jungguck/mobile_robot_proto_type/docs/wiki/entities/Relay_Robot_Hardware.md

# 🤖 Relay Robot Hardware

이 페이지는 프로젝트에 사용된 주요 하드웨어 구성 요소와 사양을 기록합니다.

## DDSM400 모터
- **타입**: Direct Drive Smart Motor (차륜형 로봇용).
- **특징**: 고토크, 정밀 인코더 내장.
- **통신**: Waveshare DDSM 드라이버 HAT 을 통한 JSON over Serial (`/dev/motor`, 115200).

### 통신 규약 (2026-08-22 실측 확정)
| 항목 | 값 |
|---|-----|
| 보드 타입 설정 | `{"T":11002,"type":210}` — **전원 사이클당 1회 필수** |
| 속도 제어 | `{"T":10010,"id":N,"cmd":X,"act":10}` |
| 모드 설정 | `{"T":10012,"id":N,"mode":2}` (2 = speed loop) |
| `cmd` / `spd` 단위 | **0.1 RPM** (cmd 100 = 10 RPM) |
| 피드백 | `{"T":20010,"id":..,"typ":400,"spd":..,"crt":..,"tep":..,"err":0}` |
| 피드백 시점 | **명령을 받았을 때만** 회신 (주기적 전송 없음) |
| heartbeat | 기본 `-1` = **비활성**. 정지 명령 없으면 무한 회전 |

> ⚠️ **`type` 은 반드시 `210`.** 모터는 스스로를 `typ:400` 이라고 보고하지만,
> 펌웨어(`ddsm_example.ino: set_ddsm_type`)는 `115` / `210` 만 인정하고
> 그 외 값은 **조용히 무시**한다. 이걸 빼먹으면 보드가 구동 명령에 응답조차 하지 않는다.
> 자세한 내용: [[Debugging_Experience#7]]

### 모터 배치 / 부호 규약 (2026-08-22 실측 확정)
| 항목 | 값 |
|---|-----|
| id = 1 | **오른쪽** 바퀴 |
| id = 2 | **왼쪽** 바퀴 |
| 전진 부호 | R = **음수**, L = **양수** |

> 좌우 허브모터가 거울 대칭으로 장착돼 있다.
> 이 부호는 `MotorDriver` 의 `DIR_R = -1` / `DIR_L = +1` 이 전부 흡수하므로,
> **드라이버 바깥에서는 부호를 건드리지 마라.** ("+ = 로봇 전진") [[Debugging_Experience#9]]

### 기구학 설정값
| 항목 | 값 | 상태 |
|---|-----|---|
| 바퀴 반지름 | 0.0325 m (지름 65mm) | ✅ **확정** (2026-09-03) |
| 양 바퀴 중심거리 | 0.22 m | ✅ **확정** (2026-09-03) |
| spd → m/s 변환 계수 | `/600.0` | ✅ 확정 |
| 명령 변환 계수 | `×600` (`calculate_rpms()`) | ✅ 확정 |

> ✅ **기구학 상수는 전부 확정됐다. 재측정을 제안하지 말 것.**
> 2026-08-22 문서에 있던 "지름 6.5cm vs 역산 7.4cm 14% 불일치" 는 **무효다.**
> 그 근거였던 60cm 는 줄자 실측이 아니라 눈대중이었고, 이후 확인 결과 6.5cm 가 맞다.
> 즉 **모순은 처음부터 없었다.** 자세한 경위는 `docs/DEBUG_LOG_2026-09-03.md` 2절.

## RPLidar (2026-09-06 실측 정정)

> ⚠️ 이전에 "A1/A2 계열" 로 적혀 있었으나 **틀렸다.** 실물은 **1,000,000 보드**를 쓰는
> **S2/S3 계열**이다. A1 설정(115200)으로 띄우면 `SL_RESULT_OPERATION_TIMEOUT` 으로 죽는다.

| 항목 | 값 | 근거 |
|---|-----|---|
| 포트 | `/dev/rplidar` (CP2102N, `10c4:ea60`) | udev 규칙 |
| **보드레이트** | **1000000** | 프로토콜 직접 탐색 (115200/256000/460800 전부 무응답) |
| scan_mode | `DenseBoost` | `sllidar_s2_launch.py` |
| model 코드 | `0x81` (펌웨어 1.02 / 하드웨어 18) | `GET_INFO` 응답 |
| 스캔 주기 | **10 Hz** | 실측 `ros2 topic hz /scan` |
| 스캔당 유효 포인트 | **2780개** | 실측 |
| angle_increment | 0.00194 rad (약 0.111°) | 실측 |
| range_min / max | 0.05 m / **40 m** | 실측 (40m 면 S3 가능성) |
| **Topic** | `/scan` | |
| **Frame ID** | `lidar_v1_1` | 메인 launch 가 지정. 단독 launch 기본값은 `laser` 라 다름 |

**단독 실행 시:**
```bash
ros2 launch sllidar_ros2 sllidar_s2_launch.py serial_port:=/dev/rplidar
```
> ★ `serial_port` 를 반드시 넘길 것. launch 기본값이 `/dev/ttyUSB0` 인데 **그건 IMU 다.**
> 메인 launch(`real_robot_260519.launch.py`)는 이미 올바르게 지정돼 있다.

## EB-IMU
- **모델**: E2BOX EBIMU9DOFV5. 포트 `/dev/ttyimu` (CP2102, 115200).
- **역할**: EKF 의 방향(yaw) 소스. 바퀴 오도메트리의 회전 오차를 보정.
- **[2026-09-22] 선택 사항이 됐다.** 2D SLAM 에서 yaw 를 잡는 주체는 라이다
  scan matching 이므로 IMU 없이 돈다(기본값). `use_imu:=true` 로만 위 역할을 한다.
  대신 매핑 중 각속도 ≤ 0.5 rad/s 를 지켜야 한다 — IMU 가 없으면 스캔 내 모션
  왜곡(de-skew)을 보정할 수단이 없다. 근거: `docs/DEBUG_LOG_2026-09-22.md`.
- **Topic**: `/ebimu_data` (`sensor_msgs/Imu`)

### 출력 포맷 (2026-08-22 실측)
현재 이 센서는 **자세 3개 필드만** 내보낸다.
```
*ROLL,PITCH,YAW        예: *-5.82,-2.39,135.80
```
9개 필드(`*ROLL,PITCH,YAW,ACCX,ACCY,ACCZ,GYROX,GYROY,GYROZ`) 설정도 가능하지만
지금은 그렇게 설정돼 있지 않다.

> ⚠️ **가속도·자이로 값이 없다.** 따라서 EKF 에서 `v_yaw` 와 선가속도를 쓸 수 없고,
> 절대 yaw 만 사용한다. `ebimu_publisher.py` 는 두 포맷을 모두 처리하며,
> 3필드일 때는 해당 항목의 `covariance[0]` 을 `-1`(미제공)로 표시한다.
> [[Debugging_Experience#11]]

## 전원 (2026-09-06 조사 + 실측)

**현재 구성: 모터와 젯슨은 전원을 따로 공급한다.** (공유 레일이 아니므로 모터 기동 시
전압 강하로 젯슨이 리셋될 위험은 없다. 이 분리를 깨지 말 것 — 아래 '왜 중요한가' 참고)

| 장치 | 입력 전압 | 소비 | 근거 |
|---|---|---|---|
| Jetson Orin Nano 개발자킷 | **DC잭 9–20V** (권장 19V) | 유휴 4.74W, 센서 2개 구동 시 4.04W, 모드 **15W** | 캐리어보드 P3768 회로도 `DC JACK POWER PATH ... VOLTAGE:9V-20V` + INA3221 실측 |
| DDSM400 ×2 | 정격 **25.2V** | 정격 0.24±0.07A, 무부하 0.25A, 구속 1.0±0.2A | Waveshare 사양 |
| RPLidar (S2 계열) | 5V | 스캐너 300~350mA, 모터 100mA, 기동 서지 500~600mA | Slamtec 데이터시트 |
| EBIMU | 5V (USB) | 무시 가능 | |

> **2026-09-13 현재 구성 변경 중 — 12V.** 젯슨 DC잭 9–20V 범위 안이라 동작은 정상이나
> 모터는 정격 25.2V 대비 **최고속도가 절반 이하**가 된다(아래 표). 전원 분리는 유지한다.
> 같은 날 **USB 장치 3개가 모두 물리적으로 분리된 상태**가 확인됐다 — `lsusb` 에 허브 2개와
> 블루투스뿐이고 `/dev/motor`·`/dev/rplidar`·`/dev/ttyimu` 가 전부 없다. udev 규칙은 젯슨에
> 남아 있으므로 다시 꽂으면 별칭도 복귀한다. `docs/DEBUG_LOG_2026-09-13.md` 6·7절

### 12V 로 구동할 때 알아둘 것

세 장치 모두 12V 에서 **동작은 한다.** 다만 모터는 정격이 25.2V 라 대가가 있다.

| | 25.2V (정격) | **12V** |
|---|---|---|
| 무부하 회전수 | 400 RPM | **약 190 RPM** |
| 바퀴 선속도 (r=0.0325) | 1.36 m/s | **약 0.65 m/s** |

속도상수가 **15.9 RPM/V** 이므로 최고 회전수가 전압에 정비례한다.
**토크는 안 줄어든다** — 토크상수(0.3 Nm/A)는 전압과 무관하고, 12V 는 속도 천장만 만든다.

> ⚠️ **"로봇이 이상하게 느리다" 는 코드 문제가 아닐 수 있다.**
> 12V 로 물려 있으면 최고속도가 원래 절반 이하다. `rpm_scale` 이나 기구학 상수를
> 다시 의심하지 말 것 — 그 값들은 2026-09-03 에 확정됐다.

### 왜 전원 분리가 중요한가

모터 기동·구속 순간 전류가 튀면 레일 전압이 주저앉는다. 젯슨과 레일을 공유하는데
순간적으로 **9V 아래로 떨어지면 젯슨이 브라운아웃으로 리셋된다.**
이 젯슨은 **SD 카드 부팅**이라 쓰기 중 리셋은 곧 카드 손상이다. 실제로 한 번 겪었다.

공유 레일을 쓸 수밖에 없다면: 젯슨 입력단 벌크 커패시터 + 12V 기준 **5A(60W) 이상** 공급.
## 제어 PC (로봇 탑재) — 2026-09-06 갱신

> 이전에 "Ubuntu 20.04 / ROS 2 Foxy" 로 적혀 있었으나 **낡은 정보다.**
> 지금은 젯슨이 직접 노드를 돌린다.

| 항목 | 값 |
|---|-----|
| 보드 | **Jetson Orin Nano 개발자 키트** (호스트명 `frlab`) |
| OS | Ubuntu 22.04 (JetPack 6.2.1 / L4T R36.4.7, aarch64) |
| ROS | **ROS 2 Humble** (`/opt/ros/humble`) |
| 부팅 장치 | **SD 카드** `/dev/mmcblk0p1` (ext4, 57G) — 전원 차단에 취약 |
| 메모리 | 7.4 GB |
| 전원 모드 | 15W |
| 접속 | `ssh robot` (키 인증). `docs/REMOTE_ACCESS.md` |
| 워크스페이스 | `~/mobile_robot_proto_type` (`colcon build --symlink-install`) |

> ⚠️ **numpy 는 2.2.6 이고 의도된 것이다. 1.x 로 내리지 말 것.**
> tube MPC 스택(`cvxpy`/`osqp`/`clarabel`)이 요구한다. ROS 라이브러리가 numpy 2 에서
> 깨지면 numpy 를 내리지 말고 그 라이브러리를 올린다. `docs/DEBUG_LOG_2026-09-06.md` 3절.

**비고**: 코드는 Foxy / Humble / Jazzy 모두에서 빌드된다. 자세한 호환표는 README 참고.
