jungguck/mobile_robot_proto_type/README_ROBOT.md

# Relay Robot: ROS2 MPC + SLAM 자율주행

DDSM400 모터 + RPLidar(S2 계열) 기반 차동 구동 모바일 로봇.  
Cartographer SLAM으로 지도 생성 → A* 경로 계획 → Tube-MPC 제어기로 목표 좌표 자율 주행.

> **IMU 는 선택 사항이다 (2026-09-22 기준 기본값: 끔).** 2D SLAM 은 라이다 scan matching 이
> yaw 를 잡아주므로 IMU/EKF 없이 돈다. 바퀴 오도메트리의 드리프트는 cartographer 가
> `map → odom` TF 로 흡수한다. IMU + EKF 구성으로 되돌리려면 `use_imu:=true`.
> 자세한 근거는 `docs/DEBUG_LOG_2026-09-22.md`.

---

## 파일 구조 및 관계도

> **2026-09-22 정리.** 안 쓰는 파일은 전부 `old_file/` 로 옮겼다 (지운 게 아니다).
> 무엇을 왜 옮겼는지는 `old_file/README.md`. 아래가 **지금 실제로 도는 전부**다.

### 읽는 순서 (공부할 때)

```
1. real_robot_driver_260519.py   모터 + 바퀴 오도메트리 + TF     <- 여기부터
2. motor_drive_1.py              시리얼 프로토콜 (부호·단위가 여기서 흡수됨)
3. my_cartographer.lua           SLAM 파라미터
4. path_planner.py               A* — 지도 팽창 + 격자 탐색
5. bridge_node.py                Tube-MPC — 참조 궤적 + QP
6. TubeMPCPlanner.py             MPC 수학 (제약 집합 / tube)
```

### 활성 파일 전체

```
src/
├── relayrobot_description/              ★ 로봇 본체 패키지
│   ├── relayrobot_description/
│   │   ├── real_robot_driver_260519.py  ★ 모터 + 휠 odom + TF (use_imu 로 동작 바뀜)
│   │   ├── motor_drive_1.py             ★ DDSM 시리얼. 부호(DIR_L/DIR_R)·단위를 흡수
│   │   ├── odom_calibrate.py              기구학 보정 도구 (직진/회전)
│   │   └── odom_listener.py               /odom 을 터미널에 찍는 최소 예제
│   │                                        (2026-09-22 에 relayrobot_driver 의
│   │                                         odom_sub 와 합쳤다)
│   ├── launch/
│   │   ├── real_robot_260519.launch.py  ★ 메인. 모터+LiDAR (+IMU/EKF 는 use_imu:=true)
│   │   └── cartographer.launch.py       ★ SLAM
│   ├── config/
│   │   ├── my_cartographer.lua          ★ SLAM 파라미터 (use_imu_data=false)
│   │   ├── ekf.yaml                       use_imu:=true 일 때만 쓰임
│   │   └── nav.rviz                       PC 용 RViz 프리셋
│   └── urdf/relayrobot.xacro            ★ 링크·조인트. lidar_v1_1 위치가 SLAM 에 직결
│
├── mpc_tubempc_bridge/                  ★ 자율주행 (SLAM -> A* -> MPC)
│   └── src/mpc_tubempc_bridge/
│       ├── path_planner.py              ★ A* + 장애물 팽창 (/map -> /global_path)
│       └── bridge_node.py               ★ Tube-MPC. TF(map->base_link)로 위치를 받는다
│
├── ddsm_example/
│   ├── mpc_tubempc/TubeMPCPlanner.py    ★ MPC 수학. bridge_node 가 sys.path 로 가져온다
│   │                                       (경로가 코드에 박혀 있어 옮기면 안 됨)
│   └── ddsm_example/*.ino, json_cmd.h     보드 펌웨어 소스.
│                                           프로토콜이 의심되면 문서 말고 이걸 본다
├── ebimu_pkg/ebimu_pkg/ebimu_publisher.py  IMU 드라이버. use_imu:=true 일 때만
├── gui_py/gui_py/hardware_test.py       ★ 원격 조종 GUI (/cmd_vel 발행). ssh -X 로 띄움
└── sllidar_ros2/                          서드파티. 우리는 sllidar_s2_launch.py 만 씀

scripts/robot-up.sh                      ★ tmux 상시 기동 (sensors|full|slam|nav)
tools/odom_check.py                        PC 에서 원격 오도메트리 진단
tools/mpc_sim.py                           로봇 없이 MPC 리허설
docs/DEBUG_LOG_<날짜>.md                  ★ 세션 기록. 최신 것이 정본
old_file/                                  보관소. COLCON_IGNORE 라 빌드 영향 없음
```

> ★ = 실주행 체인에 직접 관여. 나머지는 도구/보조.

### 토픽 / TF 흐름

```
[하드웨어]                [드라이버 노드]              [토픽]
/dev/ttyACM0  ──►  real_robot_driver_260519  ──►  /odom_raw  (nav_msgs/Odometry)
                                             ──►  /joint_states
                   sub: /cmd_vel ◄───────────────────────────
/dev/rplidar  ──►  sllidar_node              ──►  /scan      (sensor_msgs/LaserScan)

  ※ 위 /odom_raw 는 use_imu:=true 일 때의 토픽 이름이다.
    기본(IMU 없음)에서는 드라이버가 /odom 과 TF 를 직접 낸다 ↓

[오도메트리]  — 기본: IMU 없음
real_robot_driver_260519  ──►  /odom (nav_msgs/Odometry)
                          ──►  TF: odom → base_link

[오도메트리]  — use_imu:=true 일 때만
/dev/ttyimu ──► ebimu_publisher ──► /ebimu_data ──┐
                                                  ├──► ekf_filter_node ──► /odom
                         real_robot_driver ──► /odom_raw ──┘            ──► TF: odom → base_link

[SLAM]
/scan + TF(odom→base_link)  ──►  cartographer_node  ──►  /map (OccupancyGrid)
                                                     ──►  TF: map → odom
                                                          (= 누적 드리프트 보정분)

[경로 계획]
/map + TF(map→base_link) + /mpc_goal  ──►  path_planner (A*)  ──►  /global_path

[MPC 제어]
TF(map→base_link) + /global_path  ──►  bridge_node (TubeMPC)  ──►  /cmd_vel
                           (내부 의존: ddsm_example/mpc_tubempc/TubeMPCPlanner.py)

  ※ 제어·계획은 /odom 이 아니라 map→base_link TF 를 쓴다. /odom 은 odom 프레임이고
    목표·경로는 map 프레임이라 서로 원점이 다르다. 차이가 곧 SLAM 보정분이다.
    (src/mpc_tubempc_bridge/.../pose_source.py)

[TF 트리 전체]
map ──[cartographer]──► odom ──[드라이버 또는 ekf_node]──► base_link
                                                            └─[robot_state_publisher]──► lidar_v1_1
                                                                                      ──► left_wheel_v1_1
                                                                                      ──► right_wheel_v1_1
  ★ odom→base_link 발행자는 **반드시 하나**여야 한다. use_imu 가 그걸 결정한다.
```

### 주요 ROS2 토픽 정리

| 토픽 | 타입 | 발행 노드 |
|---|---|---|
| `/odom` | `nav_msgs/Odometry` | real_robot_driver_260519 (기본) |
| `/odom_raw` | `nav_msgs/Odometry` | real_robot_driver_260519 (`use_imu:=true` 일 때) |
| `/odom` | `nav_msgs/Odometry` | ekf_filter_node (`use_imu:=true` 일 때, remapped) |
| `/ebimu_data` | `sensor_msgs/Imu` | ebimu_publisher (`use_imu:=true` 일 때) |
| `/scan` | `sensor_msgs/LaserScan` | sllidar_node |
| `/map` | `nav_msgs/OccupancyGrid` | cartographer_node |
| `/mpc_goal` | `geometry_msgs/PoseStamped` | 외부 입력 (ros2 topic pub / GUI) |
| `/global_path` | `nav_msgs/Path` | path_planner |
| `/cmd_vel` | `geometry_msgs/Twist` | bridge_node |

---

## 시스템 요구사항

> **2026-09-22 정정. 이 문서는 예전에 Jazzy/Ubuntu 24.04 로만 적혀 있었는데 틀렸다.**
> 로봇(젯슨)은 **JetPack 6.2.1 = L4T 36.x = Ubuntu 22.04 = ROS 2 Humble** 이다.
> `ros-jazzy-*` 를 22.04 에 설치하려 하면 패키지를 못 찾는다.
> 근거: `docs/DEBUG_LOG_2026-09-03.md` 4절, `docs/JETSON_SETUP.md`.

| | 로봇 (젯슨 Orin Nano) | 개발 PC |
|---|---|---|
| OS | **Ubuntu 22.04** (JetPack 6.2.1) | Ubuntu 24.04 |
| ROS | **Humble** | Jazzy |
| 역할 | 드라이버·SLAM·A* ·MPC — **제어 루프 전부** | RViz·rqt·진단 도구 |

- Python: 3.10+ (젯슨 3.10)
- 필수 Python 패키지: `numpy scipy cvxpy polytope osqp cvxopt`
- **numpy 는 2.2.6 이고 내리면 안 된다.** tube MPC 스택이 요구한다. ROS 라이브러리가
  numpy 2 에서 깨지면 그 라이브러리를 올려서 푼다 (`transforms3d>=0.4.2`).
  근거: `docs/DEBUG_LOG_2026-09-06.md` 3절.

> PC(Jazzy) ↔ 젯슨(Humble) 은 표준 메시지만 쓰므로 cross-distro 로 토픽이 그대로
> 오간다 (`ROS_DOMAIN_ID=0`). 근거: `docs/DEBUG_LOG_2026-09-07.md`.

---

## 하드웨어 포트 매핑

| 장치 | 포트 | 프로토콜 |
|---|---|---|
| DDSM HAT(B) 모터 컨트롤러 | **`/dev/motor`** | USB-CDC, 115200 bps, ESP32 JSON 모드 |
| EBIMU9DOFV5 IMU (**선택**) | `/dev/ttyimu` | UART, 115200 bps |
| RPLidar **S2 계열** | `/dev/rplidar` | UART, **1,000,000 bps** |

> **udev 별명(`/dev/motor` 등)이 정본이다.** `/dev/ttyUSB*` 는 꽂는 순서마다 바뀐다.
> 특히 `/dev/ttyUSB0` 는 **IMU** 라서, 라이다 launch 기본값을 그대로 쓰면 IMU 를 연다.
>
> **라이다는 A1/A3 가 아니라 S2 계열이다** (2026-09-06 실측 정정).
> `sllidar_a1_launch.py` 로는 `SL_RESULT_OPERATION_TIMEOUT` 으로 죽는다.

---

## 최초 설치 (1회)

```bash
# 1. ROS 2 Humble 의존 패키지 (젯슨)
#    robot-localization 은 use_imu:=true 로 EKF 를 쓸 때만 필요하다.
sudo apt update
sudo apt install -y \
  ros-humble-cartographer-ros \
  ros-humble-tf-transformations \
  ros-humble-teleop-twist-keyboard \
  ros-humble-robot-localization

# 2. Python 의존 패키지 (polytope는 LP 솔버 cvxopt 필요)
pip3 install numpy scipy cvxpy polytope osqp cvxopt

# 3. 시리얼 권한 (재로그인 필요)
sudo usermod -aG dialout $USER

# 4. udev 규칙 (IMU, LiDAR 포트 이름 고정)
sudo bash src/relayrobot_description/scripts/setup_udev_rules.sh
# 설정 후 확인
ls -la /dev/rplidar /dev/ttyimu

# 5. 워크스페이스 빌드 (--symlink-install 필수)
# bridge_node.py가 소스 경로 기반 TubeMPCPlanner import를 사용하므로 심링크 빌드 필요
cd ~/mobile_robot_proto_type
source /opt/ros/humble/setup.bash
colcon build --symlink-install

# 6. bashrc 등록
# ROS 블록은 .bashrc 맨 "앞"(비대화형 가드보다 위)에 둬야 ssh robot '<명령>'
# 한 줄 실행에서도 환경이 잡힌다. 단, 아무것도 출력하면 안 된다 — scp 가 깨진다.
# (docs/DEBUG_LOG_2026-09-06.md 2절)
echo 'source /opt/ros/humble/setup.bash' >> ~/.bashrc
echo 'source ~/mobile_robot_proto_type/install/setup.bash' >> ~/.bashrc
source ~/.bashrc
```

---

## 단계별 실행 가이드

> 모든 터미널에서 소싱 필수:  
> `source /opt/ros/humble/setup.bash && source ~/mobile_robot_proto_type/install/setup.bash`
>
> 실전에서는 손으로 띄우지 말고 `scripts/robot-up.sh` 를 쓴다 (tmux 안에서 돌아
> SSH 가 끊겨도 노드가 안 죽는다).

---

### STAGE 1: 모터 단독 테스트

**목표:** DDSM400 시리얼 통신 확인, 전진/후진/회전 명령에 실제 응답 확인

```bash
# [터미널 1] 모터+휠오도메트리 노드 실행
ros2 run relayrobot_description real_robot_driver_260519

# [터미널 2] 전진 명령 (0.1 m/s)
ros2 topic pub /cmd_vel geometry_msgs/msg/Twist \
  "{linear: {x: 0.1}, angular: {z: 0.0}}" --once

# 정지
ros2 topic pub /cmd_vel geometry_msgs/msg/Twist \
  "{linear: {x: 0.0}, angular: {z: 0.0}}" --once

# [터미널 3] 오도메트리 확인
#   기본(IMU 없음)에서는 /odom 이다. use_imu:=true 일 때만 /odom_raw.
ros2 topic echo /odom --field twist.twist.linear
```

**성공 기준:**
- `/odom`의 `twist.linear.x`가 약 `0.1` (±30%)
- 로봇이 실제로 전진

**실패 체크리스트:**
```
[ ] ls -la /dev/motor            → 없으면 USB 재연결 / udev 규칙 확인
[ ] groups | grep dialout        → 없으면 usermod 후 재로그인
[ ] ESP32 모드 점퍼 확인          → Arduino 모드면 JSON 무응답
[ ] ros2 run 실행 로그에 "Connected" 출력 확인
```

---

### STAGE 2: IMU 단독 테스트

**목표:** EBIMU 데이터 수신, yaw 방향 정합성 확인

> **주의:** 노드 시작 후 10초간 캘리브레이션이 진행됩니다. 이 시간 동안 로봇을 움직이지 마세요.

```bash
# [터미널 1] IMU 노드
ros2 run ebimu_pkg ebimu_publisher \
  --ros-args -p port:=/dev/ttyimu -p frame_id:=base_link

# [터미널 2] 데이터 확인
ros2 topic hz /ebimu_data          # 목표: 40~60 Hz
ros2 topic echo /ebimu_data --field orientation
```

**성공 기준:**
- 40~60 Hz 발행
- 로봇을 왼쪽(반시계)으로 돌리면 yaw 값 증가

**실패 체크리스트:**
```
[ ] ls -la /dev/ttyimu              → 없으면: sudo ln -s /dev/ttyUSB0 /dev/ttyimu
[ ] 로그에 "Calibration done!" 확인  → 없으면 10초 더 대기
[ ] python3 src/ebimu_pkg/ebimu_pkg/imu_test_1.py  → raw 시리얼 데이터 직접 확인
```

---

### STAGE 3: LiDAR 단독 테스트

**목표:** /scan 발행 확인, RViz에서 장애물 시각화

```bash
# [터미널 1] LiDAR 노드
ros2 run sllidar_ros2 sllidar_node \
  --ros-args \
  -p serial_port:=/dev/rplidar \
  -p serial_baudrate:=1000000 \
  -p frame_id:=lidar_v1_1 \
  -p scan_mode:=DenseBoost

# [터미널 2]
ros2 topic hz /scan                # 목표: 10 Hz 이상

# [터미널 3] RViz
rviz2
# Fixed Frame: lidar_v1_1 / Add: LaserScan → Topic: /scan
```

**성공 기준:**
- 10 Hz 이상 발행
- RViz에서 주변 벽이 점으로 표시됨

**실패 체크리스트:**
```
[ ] ls -la /dev/rplidar            → 없으면 udev 규칙 확인
[ ] LiDAR 모터 회전 확인 (소리)
[ ] scan_mode 오류 시 파라미터 제거하거나 Standard로 변경:
    -p scan_mode:=Standard
[ ] A1 모델은 baudrate=115200 사용
```

---

### STAGE 4: Odometry 테스트 (IMU 없음 — 기본)

**목표:** 바퀴 오도메트리 → /odom 발행 + odom→base_link TF, TF 트리 완성

**선행 조건:** STAGE 1, 3 통과 (STAGE 2 = IMU 는 건너뛰어도 된다)

```bash
# [터미널 1] 전체 하드웨어 launch (이 터미널을 이후 단계에서도 유지)
ros2 launch relayrobot_description real_robot_260519.launch.py

# [터미널 2] 확인
ros2 topic list          # /odom, /joint_states, /scan 이 보여야 함 (/ebimu_data 는 없다)
ros2 topic hz /odom      # 목표: 10 Hz  ← 드라이버 타이머가 10Hz 다. EKF 의 30Hz 가 아니다
ros2 run tf2_ros tf2_echo odom base_link   # TF 출력되면 드라이버 정상

# [터미널 3] 직진 1m 후 위치 확인
ros2 topic echo /odom --field pose.pose.position
```

**성공 기준:**
- `/odom` **10 Hz** 발행
- `tf2_echo odom base_link` 에서 transform 출력됨
- 1m 직진 시 `position.x ≈ 0.9~1.1`

**실패 체크리스트:**
```
[ ] /odom 이 아예 없다        → 드라이버 로그의 "odom_topic=/..., publish_tf=..." 줄 확인.
                                odom_raw 로 떠 있으면 use_imu 가 true 로 넘어간 것이다.
[ ] TF 가 없다                → 같은 로그의 publish_tf=False 면 드라이버가 TF 를 안 낸다
[ ] TF 값이 튄다              → odom→base_link 발행자가 둘일 때의 증상.
                                ros2 run tf2_tools view_frames 로 확인.
                                ros2 run relayrobot_driver main_driver 를 따로 띄우지 말 것
```

**IMU + EKF 구성으로 확인하려면** (`use_imu:=true`):
```bash
ros2 launch relayrobot_description real_robot_260519.launch.py use_imu:=true
ros2 topic hz /odom        # 이때는 EKF 가 내므로 ~30 Hz
ros2 topic hz /odom_raw    # 드라이버 원본, 10 Hz
```
이 경우 STAGE 2(IMU 단독 테스트)를 먼저 통과해야 한다. `robot_localization` 설치와
`ekf.yaml` 설치 경로도 확인할 것:
```
ros2 pkg list | grep robot_localization
ls $(ros2 pkg prefix relayrobot_description)/share/relayrobot_description/config/ekf.yaml
```

---

### STAGE 5: SLAM (Cartographer) 매핑

**목표:** 지도 생성, TF map→odom 발행 확인

**선행 조건:** STAGE 4의 `real_robot_260519.launch.py`가 계속 실행 중이어야 함

```bash
# [터미널 2] Cartographer 실행 (터미널 1의 launch는 유지)
ros2 launch relayrobot_description cartographer.launch.py

# [터미널 3] 확인
ros2 topic hz /map                          # 1 Hz 내외
ros2 run tf2_ros tf2_echo map odom          # map→odom TF 출력 확인

# [터미널 4] 키보드로 로봇 조종하며 매핑
ros2 run teleop_twist_keyboard teleop_twist_keyboard

# [터미널 5] RViz
rviz2
# Fixed Frame: map / Add: Map(/map), LaserScan(/scan), TF
```

**지도 저장:**
```bash
ros2 run nav2_map_server map_saver_cli -f ~/robot_map
# 결과: ~/robot_map.pgm + ~/robot_map.yaml
```

**성공 기준:**
- `tf2_echo map odom`에서 데이터 출력
- RViz에서 회색 지도가 주행 경로를 따라 생성됨

**실패 체크리스트:**
```
[ ] cartographer_ros 설치: ros2 pkg list | grep cartographer
[ ] my_cartographer.lua 설치 확인:
    ls $(ros2 pkg prefix relayrobot_description)/share/relayrobot_description/config/my_cartographer.lua
[ ] lidar frame_id 확인: ros2 topic echo /scan --field header.frame_id
    → "lidar_v1_1" 이어야 함 (lua의 tracking_frame과 일치 필수)
[ ] STAGE 4 launch가 실행 중인지 확인 (robot_state_publisher가 없으면 TF 오류)
```

---

### STAGE 6: MPC 제어기 + 좌표 입력 자율주행

**목표:** 목표 좌표 입력 → A* 경로 계획 → Tube-MPC 추종 → 자율 주행

**선행 조건:**
- `polytope`, `cvxpy`, `cvxopt` 설치 완료
- STAGE 5 통과 (map 생성 완료)
- `colcon build --symlink-install`로 빌드됨

```bash
# [터미널 1] 하드웨어 launch (유지)
ros2 launch relayrobot_description real_robot_260519.launch.py

# [터미널 2] Cartographer (유지)
ros2 launch relayrobot_description cartographer.launch.py

# [터미널 3] A* 경로 계획 노드
ros2 run mpc_tubempc_bridge mpc_tubempc_path_planner

# [터미널 4] MPC Bridge 노드
ros2 run mpc_tubempc_bridge mpc_tubempc_bridge \
  --ros-args \
  -p use_goal_topic:=true \
  -p use_global_path:=true \
  -p velocity_limit:=0.2 \
  -p omega_limit:=1.0 \
  -p horizon:=6

# [터미널 5] 목표 좌표 발행 (map 좌표 기준, 1~2m 이내 짧은 거리부터 테스트)
ros2 topic pub /mpc_goal geometry_msgs/msg/PoseStamped \
  "{header: {frame_id: 'map'}, pose: {position: {x: 1.0, y: 0.0, z: 0.0}, orientation: {w: 1.0}}}" \
  --once

# [터미널 6] 모니터링
ros2 topic echo /cmd_vel                    # MPC 출력 확인
ros2 topic echo /global_path --no-arr       # A* 경로 확인
```

**성공 기준:**
- `/global_path` 발행됨 (A* 경로 계산 성공)
- `/cmd_vel`이 0이 아닌 값으로 발행됨
- 로봇이 목표 방향으로 이동 후 정지
- `/odom`의 `position.x/y`가 목표 ±0.3m 이내

**실패 체크리스트:**
```
[ ] ImportError (TubeMPCPlanner) → 반드시 colcon build --symlink-install 로 재빌드
[ ] ImportError (polytope/cvxpy) → pip3 install polytope cvxpy osqp cvxopt
[ ] /global_path 없음 → A* 노드가 /map 수신 대기 중 (Cartographer 실행 확인)
[ ] "Start or goal cell is not free" → 목표가 장애물 위, 다른 좌표 시도
[ ] MPC QP failed → velocity_limit:=0.1, horizon:=4로 줄여서 재시도
[ ] /cmd_vel 발행되나 로봇 미동 → use_goal_topic:=true 파라미터 확인
[ ] 로봇이 목표 반대 방향 → wheel_base 부호 하드웨어 실측 필요
```

---

## 트러블슈팅

### 모터 미응답
```bash
python3 src/relayrobot_driver/relayrobot_driver/motor_test_1.py
# → "Connected" 출력 안 되면 USB, ESP32 모드 점퍼, 전원 순서로 확인
```

### EKF /odom 미발행
```bash
ros2 pkg list | grep robot_localization
# → 없으면: sudo apt install ros-humble-robot-localization   (use_imu:=true 일 때만 필요)
```

### Cartographer apt 설치 안 될 때
```bash
# cartographer 가 없을 경우 slam_toolbox 대체 사용
sudo apt install ros-humble-slam-toolbox
# my_slam_params.yaml의 use_sim_time: false 유지
ros2 launch slam_toolbox online_async_launch.py \
  params_file:=src/relayrobot_description/my_slam_params.yaml
```

### RViz에서 로봇 떨림 (TF 이중 발행)
```bash
ros2 run tf2_ros tf2_monitor
# odom→base_link 발행자가 2개이면 real_robot_driver의 TF 브로드캐스터 비활성화
# (real_robot_driver_260519.py는 이미 비활성화됨)
```

### MPC 발산 / 진동
```bash
# 제약 완화: velocity_limit, omega_limit 줄이기
# horizon 줄이기: -p horizon:=4
# 먼저 1m 이내 짧은 거리로 테스트
```
