jungguck/mobile_robot_proto_type/read_prompt.md

너는 ROS2 Humble 기반 모바일 로봇 시스템을 문서화하는 시니어 로보틱스 엔지니어다.

아래 프로젝트 내용을 기반으로 README.md를 다시 작성해라.

목표는 단순 기술 나열이 아니라:

1. 처음 보는 사람도 시스템 구조를 이해할 수 있게 만들기
2. ROS2 TF 구조(map / odom / base_link)를 쉽게 설명하기
3. 데이터 흐름이 왜 그렇게 구성되는지 설명하기
4. 실제 디버깅 경험과 문제 해결 과정을 강조하기
5. 실행 순서를 따라 하면 실제 로봇이 동작하도록 작성하기
6. “왜 이렇게 설계했는가?”가 드러나게 만들기
7. 로봇공학 비전공자도 이해 가능한 표현 사용
8. 너무 논문처럼 딱딱하지 않게 작성
9. 핵심 개념은 시각적으로 강조
10. README 하나만 봐도 전체 시스템을 이해할 수 있게 만들기

README 구조는 아래 순서를 따라라:

# 프로젝트 소개
- 프로젝트 목적
- 사용 기술
- 시스템 특징

# 시스템 아키텍처
- 전체 데이터 흐름
- 센서 → EKF → SLAM → GUI → 제어 흐름 설명
- 왜 odom_raw 와 odom 을 분리했는지 설명

# TF 좌표계 설명
- base_link
- odom
- map
- map -> odom TF의 의미
- 왜 SLAM이 실제 위치를 보정하는지

# 핵심 문제 해결 경험
- TF 충돌 문제
- Double TF 문제
- EKF 미적용 문제
- 좀비 프로세스 문제
- MPC blind control 문제

각 문제는:
- 문제 원인
- 실제 증상
- 해결 방법
- 해결 이후 변화
형태로 설명

# 실행 방법
- 실제 로봇 실행
- GUI 실행
- SLAM 실행
- RViz 설정
- MPC 실행

각 단계마다:
- 왜 필요한지
- 실행하면 내부적으로 무엇이 실행되는지
설명

# ROS2 토픽 구조
- /odom_raw
- /odom
- /scan
- /cmd_vel
- TF 구조 설명

# 개발 시 주의점
- use_sim_time
- TF 충돌
- EKF 설정
- Cartographer 연동 시 주의사항

# 향후 목표
- Navigation2 연동
- 자율 주행
- 경로 계획
- 멀티 센서 융합

작성 스타일:
- markdown 기반
- 초보자 친화적
- 핵심 중요 내용은 강조
- 표 적극 사용
- 실제 현업 로봇 프로젝트 문서 스타일
- “왜”를 중심으로 설명
- 기술 블로그 + 오픈소스 README 스타일 혼합

아래 원본 내용을 참고해서 재구성해라:
[여기에 현재 README 내용 붙여넣기]
