jungguck/mobile_robot_proto_type/frames_2026-01-13_17.35.48.pdf

view_frames Result

Recorded at time: 1768293348.0673697

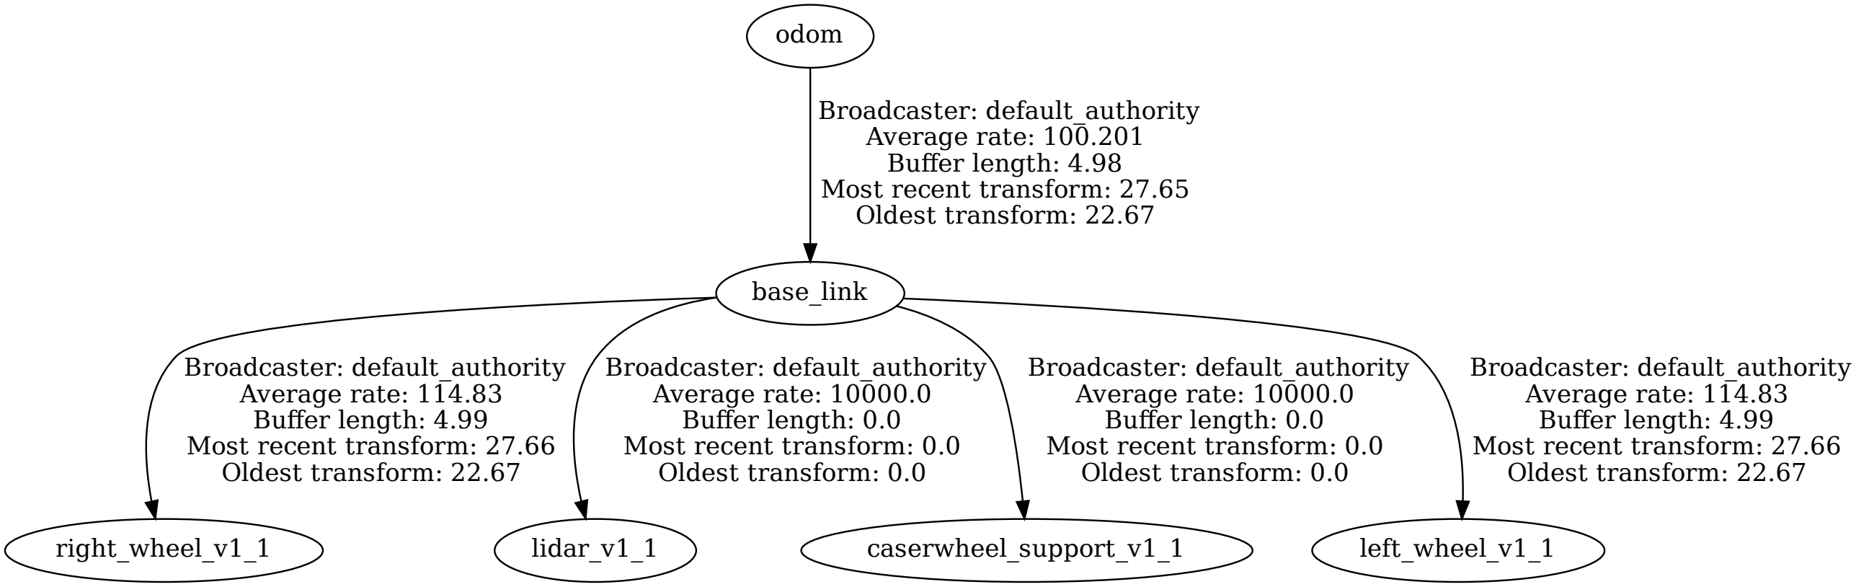
[picture p1: figure]
base_link; right_wheel_v1_1; Broadcaster: default_authority Average rate: 114.83 Buffer length: 4.99 Most recent transform: 27.66 Oldest transform: 22.67; lidar_v1_1; Broadcaster: default_authority Average rate: 10000.0 Buffer length: 0.0 Most recent transform: 0.0 Oldest transform: 0.0; caserwheel_support_v1_1; left_wheel_v1_1; odom; Broadcaster: default_authority Average rate: 100.201 Buffer length: 4.98 Most recent transform: 27.65 Oldest transform: 22.67
