jungguck/mobile_robot_proto_type/frames_2026-01-27_14.03.31.pdf

view_frames Result

Recorded at time: 1769490211.6801927

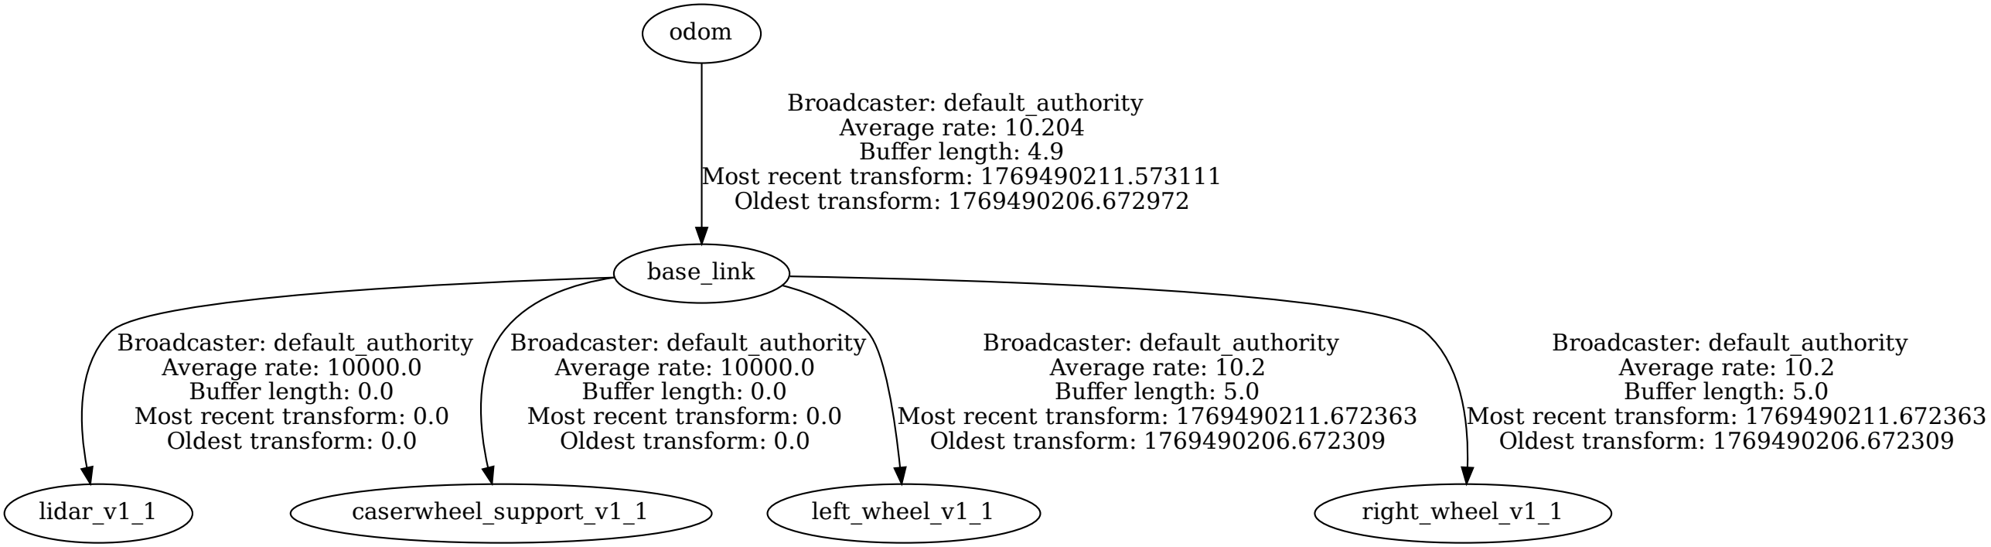
[picture p2: figure]
base_link; lidar_v1_1; Broadcaster: default_authority Average rate: 10000.0 Buffer length: 0.0 Most recent transform: 0.0 Oldest transform: 0.0; caserwheel_support_v1_1; left_wheel_v1_1; Broadcaster: default_authority Average rate: 10.2 Buffer length: 5.0 Most recent transform: 1769490211.672363 Oldest transform: 1769490206.672309; right_wheel_v1_1; odom; Broadcaster: default_authority Average rate: 10.204 Buffer length: 4.9 Most recent transform: 1769490211.573111 Oldest transform: 1769490206.672972
