jungguck/mobile_robot_proto_type/ROS2_SI.png

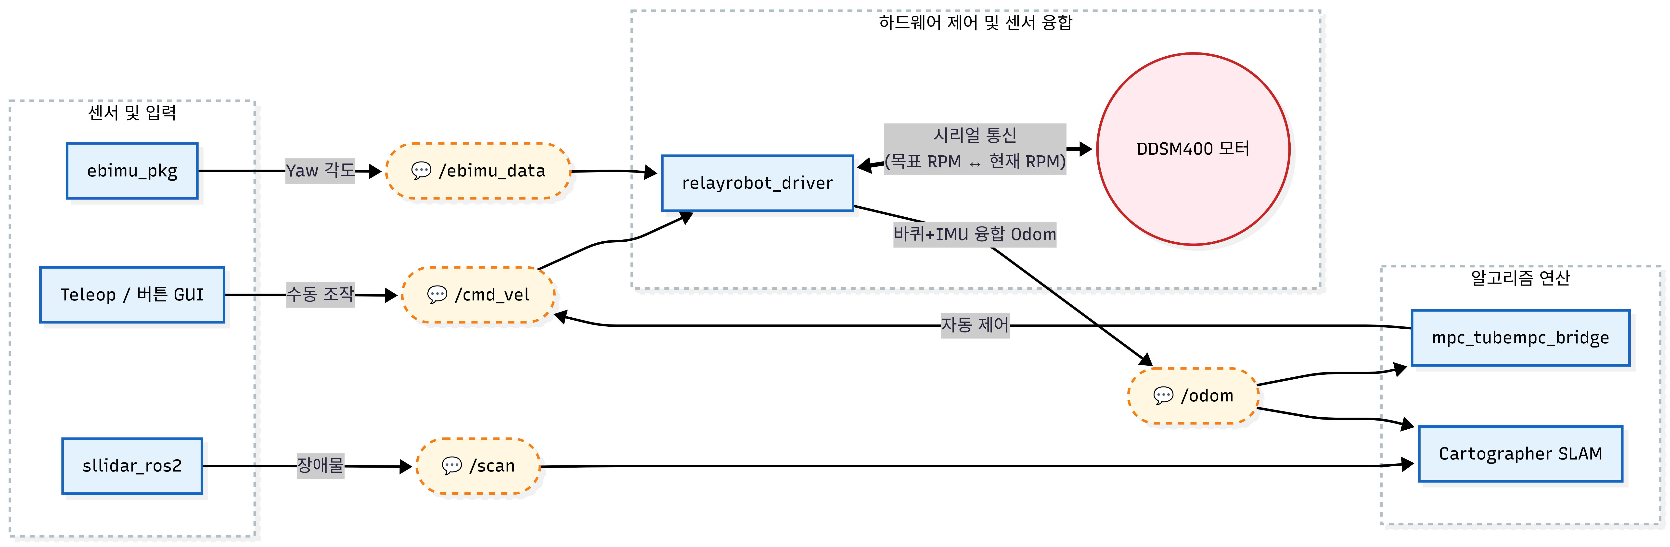
ROS2_SI.png
