jungguck/mobile_robot_proto_type/src/relayrobot_description/meshes/lidar_v1_1.stl

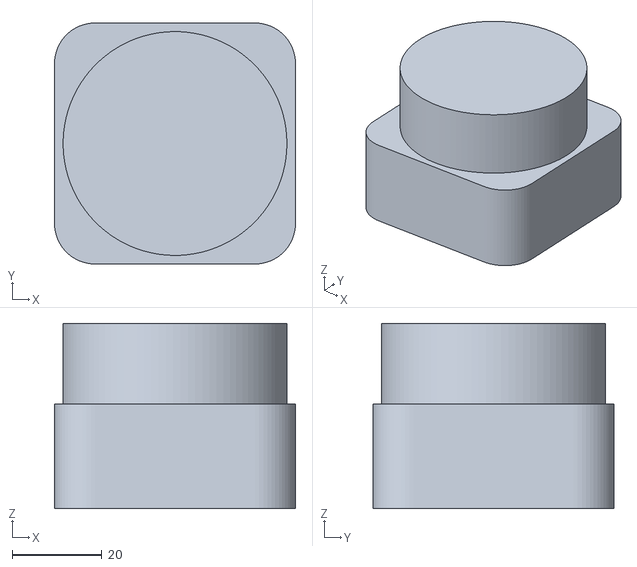
[picture p4: CAD file, 2026-05-26]
src/relayrobot_description/meshes/lidar_v1_1.stl
53.7 x 53.7 x 41.2
