jungguck/mobile_robot_proto_type/src/relayrobot_description/meshes/right_wheel_v1_1.stl

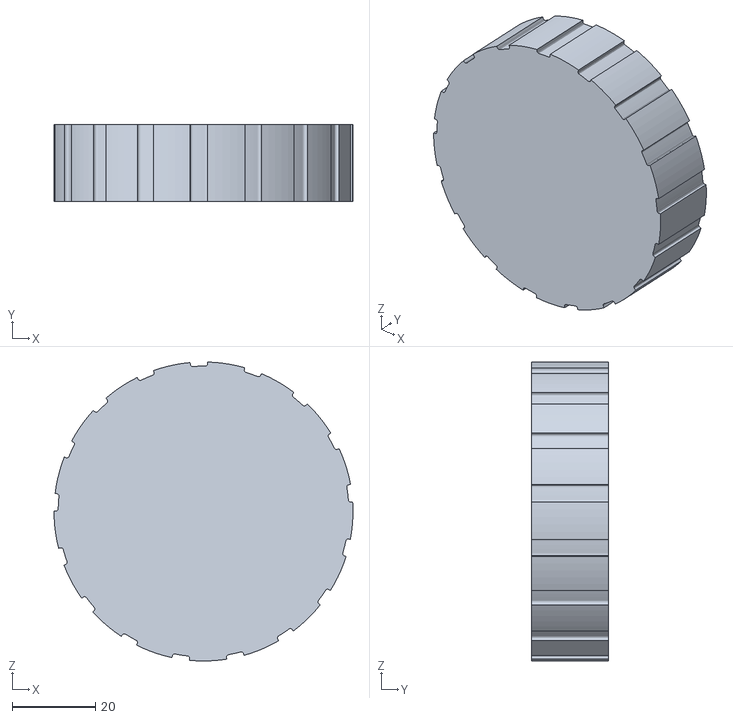
[picture p5: CAD file, 2026-05-26]
src/relayrobot_description/meshes/right_wheel_v1_1.stl
72.0 x 18.6 x 72.0
