jungguck/mobile_robot_proto_type/src/relayrobot_description/meshes/casterwhhel_v1_1.stl

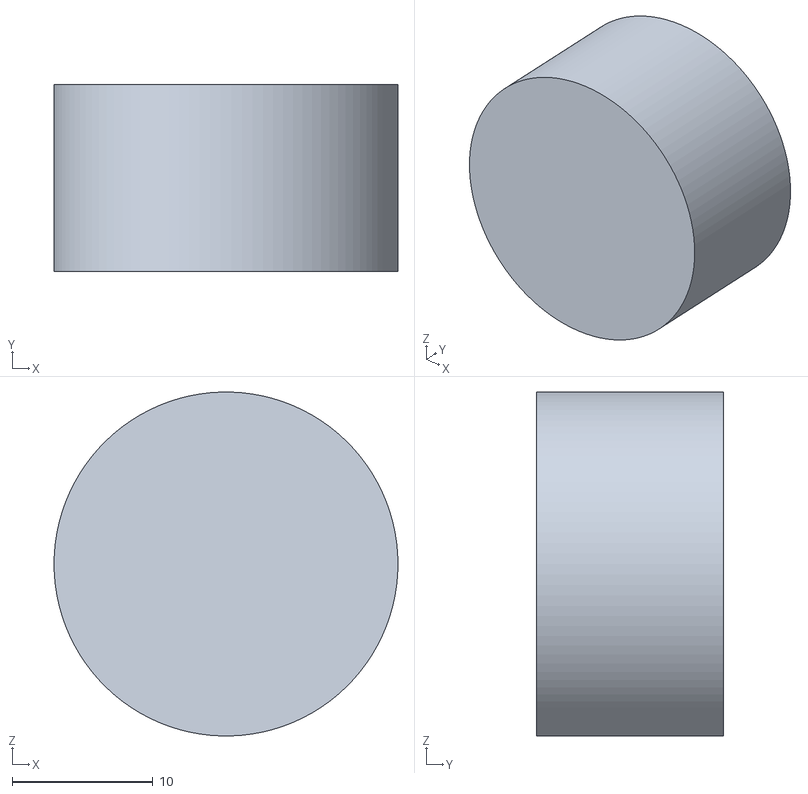
[picture p6: CAD file, 2026-05-26]
src/relayrobot_description/meshes/casterwhhel_v1_1.stl
24.4 x 13.3 x 24.4
