jungguck/mobile_robot_proto_type/src/relayrobot_description/meshes/base_link.stl

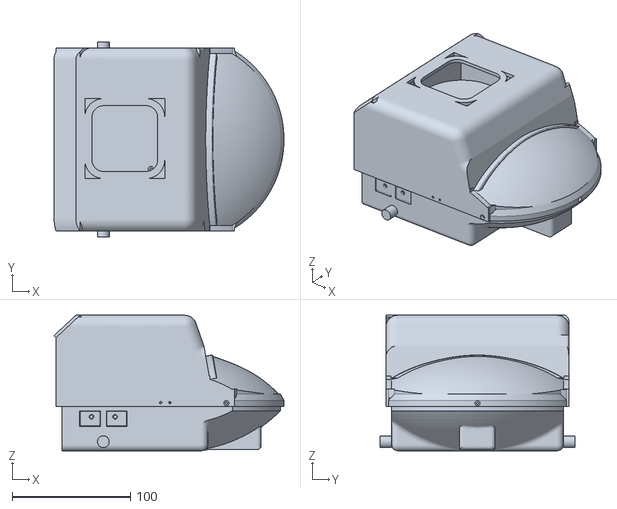
[picture p7: CAD file, 2026-05-26]
src/relayrobot_description/meshes/base_link.stl
194.4 x 165.0 x 114.5
