jungguck/mobile_robot_proto_type/src/relayrobot_description/meshes/caserwheel_support_v1_1.stl

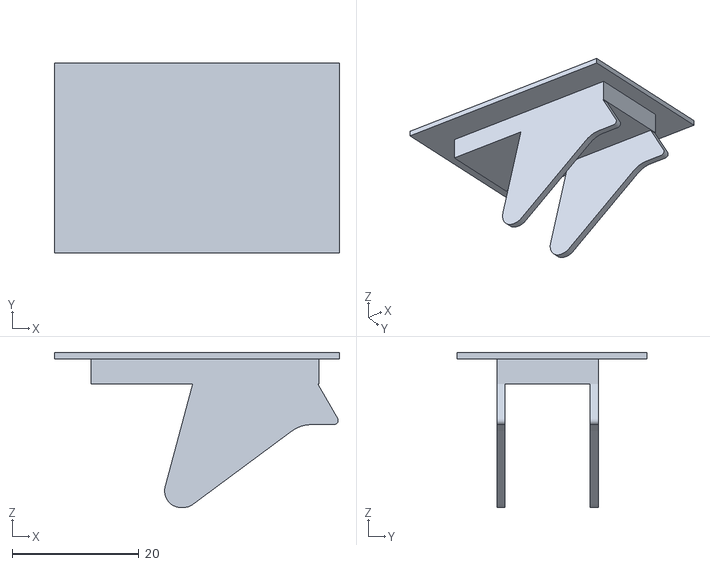
[picture p8: CAD file, 2026-05-26]
src/relayrobot_description/meshes/caserwheel_support_v1_1.stl
45.0 x 30.0 x 24.5
