jungguck/mobile_robot_proto_type/(list of files, cad)

Other CAD files:
src/relayrobot_description/meshes/left_wheel_v1_1.stl
