jungguck/mobile_robot_proto_type/docs/DEBUG_LOG_2026-09-22.md

# DEBUG LOG — 2026-09-22

**주제:** **IMU 를 빼고 라이다 + 바퀴 오도메트리만으로 돌아가게 재정립** (`use_imu` 스위치)
\+ 그 과정에서 겪은 **저장소 시차 사고**

---

## ⏳ 아직 안 한 것 — 다음 세션에서 반드시

> ### ❌ **젯슨에 빌드 안 했다.**
>
> 이날 젯슨은 **전원이 꺼져 있었다.** 코드는 PC 에서만 고쳤고 푸시까지만 했다.
> `pose_source.py` 같은 신규 파일은 없지만 **드라이버·launch·GUI 가 바뀌었으므로**
> 젯슨에서 다음을 해야 아무것도 반영되지 않는다.
>
> ```bash
> ssh robot "cd ~/mobile_robot_proto_type && git pull"
> ssh robot "cd ~/mobile_robot_proto_type && colcon build --symlink-install"
> ```
>
> `--symlink-install` 이라 파이썬 파일만 바뀌었으면 pull 만으로도 되지만,
> **launch 파일과 config(lua)는 `data_files` 로 설치되므로 재빌드가 필요하다.**
>
> 09-13 기준으로 **USB 장치가 전부 빠져 있고 전원을 12V 로 재구성 중**이었다.
> 실기 검증은 USB 부터 꽂아야 한다.

---

## 오늘의 결론

> ### ✅ IMU 는 **선택 사항**이 되었다. 기본 구성은 라이다 + 바퀴 오도메트리.

2D SLAM 에서 yaw 를 잡는 주체는 IMU 가 아니라 **라이다 scan matching** 이다.
바퀴 오도메트리는 스캔 사이 100ms 를 메우는 **초기 추정값**일 뿐이고, 누적 드리프트는
cartographer 가 `map → odom` TF 로 흡수한다.

| 센서 | 역할 |
|---|---|
| 휠 오도메트리 | 스캔 사이 단기 추측 (**초기값**) |
| 라이다 scan matching | **절대 자세 보정** — 매 스캔 yaw 드리프트를 깎아냄 |
| IMU | 빠른 회전 각속도, 슬립 감지 (**있으면 좋은 정도**) |

`my_cartographer.lua` 는 원래부터 `use_imu_data = false` 였다. SLAM 쪽은 이미 IMU 없는
구성이었고, **막고 있던 것은 TF 배선 하나뿐이었다.** (2절)

---

## 0. 다음 세션이 이것만 읽으면 되는 요약

- **❌ 젯슨 빌드 미실시.** 맨 위 참고. 여기부터 시작한다.
- **`use_imu` 런치 인자 하나로 두 구성을 오간다. 기본 `false`.**
  ```bash
  ros2 launch relayrobot_description real_robot_260519.launch.py               # IMU 없음
  ros2 launch relayrobot_description real_robot_260519.launch.py use_imu:=true # 예전 구성
  ```
  `robot-up.sh` 는 `USE_IMU=1` 환경변수로 같은 선택을 한다.
- **`odom → base_link` TF 발행자는 시스템에 하나뿐이어야 한다.** `use_imu` 가 그 책임을
  드라이버(`publish_tf`)와 `ekf_node` 사이에서 옮긴다. 이게 이번 작업의 핵심이다.
- **`ekf_node` 를 IMU 없이 띄우면 안 된다.** `ekf.yaml` 은 yaw 소스가 IMU 단독이라
  **에러 없이 조용히 `/odom` 의 yaw 가 0 에 고정된다.**
- **토픽 이름이 바뀌었다: 드라이버가 `/odom` 을 직접 낸다.** `/odom_raw` 를 구독하던
  노드를 전부 훑어 고쳤다. (4절)
- **매핑 중 각속도 ≤ 0.5 rad/s, 선속도 ≤ 0.3 m/s.** 취향이 아니라 S2 의 10Hz 스캔에서
  오는 물리적 한계다. **teleop 기본값이 그 2배라 따로 낮춰야 한다.** (5절)
- **⚠️ 저장소 시차 사고가 또 났다 — 이번엔 반대 방향이다.** (1절) 작업 전에 `git fetch` 부터.

### 지금 상태 한눈에

| 항목 | 상태 |
|---|---|
| `use_imu` 스위치 | ✅ 구현 (기본 false) |
| IMU 없이 `odom→base_link` TF | ✅ 드라이버가 직접 발행 |
| cartographer IMU-free 설정 | ✅ 원래부터 `use_imu_data=false` |
| `/odom_raw` 구독자 정리 | ✅ 전수 조사 후 수정 |
| `robot-up.sh` IMU 없이 기동 | ✅ `/dev/ttyimu` 없어도 안 죽음 |
| **젯슨 빌드** | ❌ **미실시 (전원 꺼짐)** |
| **실기 검증** | ❌ 미실시 |
| USB 장치 | ❌ 09-13 기준 전부 분리됨 |

---

## 1. ⚠️ 저장소 시차 사고 — 이번엔 반대 방향이었다

`DEBUG_LOG_2026-09-03.md` 1절의 교훈은 "실기 결과가 저장소로 안 돌아왔다" 였다.
**오늘은 정확히 반대가 났다: 저장소 내용이 로컬로 안 내려왔다.**

작업을 시작할 때 로컬 `main` 은 `42f5166`(09-06)이었고 working tree 는 clean 이었다.
그 상태로 하루치 작업을 다 한 뒤 push 하려니 거부됐다. 원격에는 커밋 3개가 있었다.

```
0f416b7 docs(wiki): concepts 갱신 + 고아 링크 2개 채움
97afd90 feat: SLAM→A*→Tube-MPC 체인 정비 — 프레임 정합/watchdog/장애물 팽창
d119113 feat: 오도메트리 원격 진단 노드(odom_check) + PC DDS 시험 워크플로우 정리
```

**즉 2주 낡은 트리 위에서 작업했다.** 그리고 그 사이 09-13 이 이미 해놓은 것과
상당 부분이 겹쳤다 (2절). 겹친 작업은 전부 버렸다.

> **규칙 추가: 작업을 시작하기 전에 `git fetch && git log HEAD..origin/main` 을 본다.**
> `git status` 가 clean 이라는 것은 **로컬이 최신이라는 뜻이 아니다.** 원격과 비교하지
> 않으면 알 수 없다. clean 한 오래된 트리가 가장 위험하다 — 아무 경고도 나오지 않는다.

**복구 방법 (merge/rebase 를 쓰지 않았다):**

```bash
git branch imu-free-wip-20260922   # 내 커밋 보존
git reset --hard origin/main       # 원격 기준으로 되돌림
# 그 위에 IMU-free 부분만 다시 적용
```

충돌 해소 방향이 "내 것 전부 버리고 원격 채택" 이라, merge 는 충돌 푸는 시간만 낭비였다.

---

## 2. 09-13 이 이미 해놓은 것 — 다시 하지 말 것

오늘 중복으로 만들었다가 버린 것들이다. **모두 `DEBUG_LOG_2026-09-13.md` 12~13절에 있다.**

| 항목 | 어디에 |
|---|---|
| `/cmd_vel` watchdog + 피드백 stale 차단 (유령 거리) | 12-1 |
| A* 장애물 팽창 + 미탐색 차단 | 12-2 |
| **tf2 로 map 프레임 일원화** (`global_frame` 파라미터) | 12-3 |
| `/mpc/*` 원격 관측 토픽 + `nav.rviz` | 12-4 |
| QP 100% 실패 원인 (`x_min` 의 θ 한계) → `error_yaw_limit` | 13 |
| `tools/mpc_sim.py` 로 로봇 없이 목표 도달 검증 | 14 |

> 특히 **12-3 은 오늘 `pose_source.py` 라는 이름으로 똑같이 다시 만들었다가 버렸다.**
> 09-13 쪽이 프레임 불일치 경고까지 있어 더 낫다. `bridge_node` / `path_planner` 는
> **건드리지 않았다.**
>
> 유령 거리도 "미해결 우선순위 1" 인 줄 알고 문서에 크게 적었는데 **이미 닫힌 항목이었다.**
> 1절의 교훈이 실제로 비용을 발생시킨 지점이 여기다.

---

## 3. 막고 있던 것은 TF 배선 하나였다

`my_cartographer.lua:38` 은 원래부터 `use_imu_data = false` 였다.
그런데 `real_robot_driver_260519.py` 는 TF 를 **일부러 안 내고** 있었다.

```python
# TF(odom→base_link)는 ekf_node가 담당 — 여기서 발행하면 이중 충돌
```

맞는 말이다. 하지만 `ekf.yaml` 은 **yaw 소스가 IMU 단독**이다 (2026-08-22 에 의도적으로
그렇게 바꿨다). 그래서 **IMU 노드만 빼면** EKF 는 방향 소스를 잃고, 드라이버는 TF 를
안 내므로 **`odom → base_link` 가 통째로 끊긴다.** cartographer 는 에러 없이 조용히
아무것도 안 한다. 이것이 IMU-free 로 가는 길을 막던 유일한 실질적 장애물이었다.

### 해결 — `use_imu` 한 스위치로 책임을 옮긴다

| | `odom_topic` | `publish_tf` | `/odom` 발행자 | TF 발행자 |
|---|---|---|---|---|
| **`use_imu:=false` (기본)** | `odom` | `True` | 드라이버 | **드라이버** |
| `use_imu:=true` | `odom_raw` | `False` | ekf_node | **ekf_node** |

launch 는 파라미터만 다른 드라이버 노드 두 벌을 두고 `IfCondition`/`UnlessCondition` 으로
**하나만** 띄운다. `imu_node` 와 `ekf_node` 도 `use_imu` 에 묶였다.

### 덤 — 타임스탬프 이중 취득 종결 (`DEBUG_LOG_2026-09-03.md` 3절 2번)

`publish_odom()` 이 `get_clock().now()` 를 **다시** 불러서 `timer_callback()` 의 적분
시각과 다른 값을 쓰고 있었다. `current_time` 을 넘겨받아 odom 메시지와 TF 가 같은
stamp 를 쓰도록 고쳤다. IMU 없이 scan matching 에만 의존하는 지금은 cartographer 가
그 차이를 자세 오차로 받아들이고, 보정해 줄 다른 센서가 없다.

---

## 4. 발행/구독 전수 조사 — 토픽 이름이 바뀌면 구독자가 굶는다

드라이버 발행 토픽이 `/odom_raw` → `/odom` 으로 바뀌었다. **발행자만 고치고 끝내면
구독자는 에러 없이 조용히 멈춘다.**

```bash
grep -rnE "create_subscription|create_publisher" --include="*.py" src/ tools/
```

| 노드 | 원래 | 판정 | 조치 |
|---|---|---|---|
| `real_robot_driver_260519` | pub `/odom_raw` | 변경 | pub `<odom_topic>` (기본 `/odom`) + TF |
| `odom_calibrate` | sub `/odom_raw` (기본값) | **깨짐** | 기본값 `/odom` |
| `tools/odom_check.py` | sub `/odom_raw` 고정 | **깨짐** | `raw_topic` 파라미터 (기본 `/odom`) |
| `gui_py/hardware_test` | sub `/odom_raw` + `/odom` | **깨짐 + 위험** | `use_ekf` 파라미터. 아래 |
| `bridge_node` / `path_planner` | TF(`global_frame`) | **이미 정상** (09-13) | 손대지 않음 |
| `odom_listener` / `odom_subscriber` | sub `/odom` | 그대로 OK | — |
| `ebimu_subscriber` | sub `/ebimu_data` | `use_imu:=true` 일 때만 | 손대지 않음 |
| `ddsm_example/motor_node_1` | pub `odom` + **TF** | 이 launch 가 안 씀 | 아래 경고 |

> ⚠️ **`ros2 run relayrobot_driver main_driver` (= `motor_node_1.py`) 를 띄우지 말 것.**
> `odom` 과 `odom → base_link` TF 를 **직접** 쏜다. 이제 드라이버도 같은 TF 를 내므로
> **발행자가 둘이 된다.** 기구학 상수도 낡았다 (`r=0.05`, `base=0.165`).
> `DEBUG_LOG_2026-09-06.md` 6-2절에서 이미 경고된 항목이다.

### `odom_calibrate` / `odom_check` — 조용히 멈춰 있을 케이스

둘 다 기본 구독이 `/odom_raw` 였다. IMU 없는 구성에서는 그 토픽이 발행되지 않으므로
**영영 오지 않는 메시지를 기다리며 아무 말도 없이 멈춰 있는다.**

- `odom_calibrate`: `odom_topic` 기본값 → `/odom`
- `odom_check`: `raw_topic` 파라미터 신설, 기본값 `/odom`

> `use_imu:=true` 로 볼 때는 각각 `-p odom_topic:=/odom_raw`, `-p raw_topic:=/odom_raw`.
> **기구학 보정은 EKF 출력이 아니라 드라이버 원본을 봐야 의미가 있다.**

> ⚠️ **`odom_check` 의 ② 회전 스케일은 IMU 없이는 쓸 수 없다.** 기준으로 삼던
> `/ebimu_data` 가 없기 때문이다. 대신 바닥 테이프 + 실측 각도로 잰다:
> ```bash
> ros2 run relayrobot_description odom_calibrate --ros-args \
>   -p mode:=rotate -p speed:=0.4 -p duration:=20.0 -p measured:=1080.0
> ```

### `hardware_test` GUI — 원격 조종 경로라서 더 중요하다

이 GUI 는 모니터가 아니라 **`/cmd_vel` 을 발행하는 원격 조종 수단**이다.
`DEBUG_LOG_2026-09-03.md` 5절에서 "하드웨어 점검 = `ssh -X` + `hw_test`" 로 채택한
경로이기도 하다 (tkinter 라 OpenGL 을 안 써서 X11 포워딩이 가볍다).

**1. 모터 패널이 영영 비어 있었다.** `/odom_raw` 고정 구독이라 실측 v/ω 가 안 들어온다.

**2. EKF Start 버튼이 TF 를 깨뜨릴 수 있었다 (진짜 위험).**
GUI 의 `MOTOR_CMD` 는 인자 없이 드라이버를 띄운다 → 이제 기본값이 `publish_tf=True` 다.
여기서 EKF Start 를 누르면 `ekf.yaml` 의 `publish_tf: true` 와 겹쳐
**`odom → base_link` 를 두 노드가 동시에 발행한다.**

조치:
- `MOTOR_CMD` 상수 → `_motor_cmd(use_ekf)` 함수. `odom_topic`/`publish_tf` 를
  **명시적으로** 넘긴다 (기본값에 의존하지 않는다).
- `use_ekf=False` 면 EKF Start 를 막고 이유를 상태바에 띄운다.
- 드라이버 행 라벨을 `EKF(off)` / `IMU(opt)` 로.

```bash
ros2 run gui_py hw_test                              # IMU 없음 (기본)
ros2 run gui_py hw_test --ros-args -p use_ekf:=true  # 예전 구성
```

> **교훈: 발행 토픽 이름을 바꿀 때는 `grep -rn create_subscription` 을 먼저 돌린다.**
> ROS 2 는 구독자 없는 토픽도, 발행자 없는 토픽도 에러를 내지 않는다. 양쪽 다 조용해서
> "노드는 떠 있는데 화면이 안 변한다" 로만 드러난다.

---

## 5. 매핑 운용 규칙 — 속도가 IMU 의 대체재다

| 항목 | 값 | 근거 |
|---|---|---|
| 각속도 | **≤ 0.5 rad/s** | S2 가 10Hz(한 스캔 100ms). 1.0 rad/s 면 한 스캔에 **5.7°** 가 번진다. IMU 없이는 포인트별 de-skew 를 할 수단이 없다 |
| 선속도 | **≤ 0.3 m/s** | 같은 이유 (병진 왜곡) |
| 제자리 회전 | **피할 것** | diff drive 에서 바퀴 슬립이 가장 심한 동작. 살짝 호를 그리며 돌 것 |

### ★ teleop 기본 속도 — 속도 제한의 구멍

`robot-up.sh nav` 는 MPC 에 `omega_limit:=0.5` 를 넘기도록 고쳤다. 그런데
**teleop 에는 아무 제한이 없다.** `teleop_twist_keyboard` 기본값은 `speed=0.5 m/s`,
`turn=1.0 rad/s` — 위 한계의 **정확히 2배**다. 매핑은 teleop 으로 하므로 그대로 띄우면
제한이 무의미해진다.

```bash
ros2 run teleop_twist_keyboard teleop_twist_keyboard \
  --ros-args -p speed:=0.15 -p turn:=0.4
```

GUI(`hw_test`)는 슬라이더가 `to=0.3` 으로 이미 막혀 있어 괜찮다.

### scan matching 이 깨지는 환경 (IMU 로도 크게 못 고친다)

- 긴 특징 없는 복도 — 진행 방향이 구속되지 않는다
- 넓은 빈 홀 — 벽이 `max_range` 밖
- 유리 / 거울 — 반사로 거리가 거짓말을 한다

### 튜닝 — `ceres_scan_matcher.rotation_weight` 40 → 20

초기 추정 각도(= 바퀴 yaw)에서 벗어나는 것에 대한 **벌점**이다. 기본 40 은 초기 추정을
꽤 믿는 값인데, 이제 그 초기 추정이 슬립 잘 나는 바퀴 yaw 하나뿐이다.

- 회전 구간에서 벽이 겹쳐 보이면 → 10 까지 더 내린다
- 특징 없는 복도에서 스캔이 헛돌면 → 40 으로 되돌린다

> `max_range = 8.0` 은 **안 건드렸다.** S2 는 30m 까지 보므로 넓은 공간에서 heading
> 구속이 약하면 12.0 정도로 올려볼 여지가 있다. 실측 후 판단할 것.

---

## 6. 젯슨이 켜지면 할 순서

```bash
# 1) 빌드 (맨 위 참고 — 이게 안 되면 아무것도 반영 안 됨)
ssh robot "cd ~/mobile_robot_proto_type && git pull && colcon build --symlink-install"

# 2) 오도메트리 + TF 부터 (라이다 없이)
ssh robot "ros2 launch relayrobot_description real_robot_260519.launch.py use_lidar:=false"
ssh robot "ros2 topic hz /odom"                        # 10 Hz
ssh robot "ros2 run tf2_ros tf2_echo odom base_link"   # 출력되면 TF 배선 성공
```

**확인 포인트:** 드라이버 시작 로그에 이 줄이 나온다.

```
Real Robot Driver Started (Wheel Odom Only) — odom_topic=/odom, publish_tf=True
```

`odom_raw` / `publish_tf=False` 로 떠 있으면 `use_imu` 가 true 로 넘어간 것이다.

### 라이다를 먼저 붙여도 되는가 — 된다

cartographer 는 오도메트리가 **정확할** 필요가 없다. `odom → base_link` TF 가
존재하기만 하면 되고, 정확도는 scan matching 이 깎아낸다. 그래서 캘리브레이션을
건너뛰고 바로 SLAM 으로 가도 된다. 위 2)는 건너뛰는 게 아니라 **30초짜리**다.

### 라이다 붙이기 전에 2분만 — 이 두 가지는 보고 간다

안 보고 매핑하면 맵이 깨졌을 때 원인 후보가 넷으로 늘어난다.

**1) 회전 부호** — 좌회전 시 `/odom` 의 yaw 가 **+ 방향으로 증가**해야 한다.

```bash
ros2 topic echo /odom --field pose.pose.orientation
```

`w_enc = (vr - vl) / wheel_base` 이므로 좌회전(+z)이면 오른쪽 바퀴가 더 빨라야 한다.
8/22 에 `DIR_L`/`DIR_R` 로 **전진** 부호는 실측 확정했지만 **회전 부호는 실측 기록이
없다.** 뒤집혀 있으면 cartographer 가 받는 초기 추정이 매 회전마다 반대 방향이고,
IMU 가 없으니 잡아줄 것이 없다.

**2) 라이다 TF / 장착 방향**

```bash
ros2 run tf2_ros tf2_echo base_link lidar_v1_1
```

- 링크가 없으면 → cartographer 가 스캔을 변환 못 해서 **조용히 아무것도 안 함**
- 있는데 회전이 틀리면 → **맵은 그려지는데 통째로 돌아가거나 뒤집혀 나옴**

두 번째가 고약하다. 로봇 정면에 벽을 두고 `/scan` 의 정면 거리(index 0 부근)가 실제와
맞는지 보면 바로 안다. (URDF 실측 불일치 중 **바퀴 간격은 SLAM 에 영향 없고
라이다 위치는 영향 있다.**)

### 그 밖의 검사

| 검사 | 명령 | 틀렸을 때 증상 |
|---|---|---|
| TF 발행자가 하나인가 | `ros2 topic info /tf --verbose` | TF 가 두 값 사이에서 튄다 |
| `use_sim_time` 전부 false | `ros2 param get /cartographer_node use_sim_time` | 시간이 안 맞아 **모든 스캔을 버린다** (에러 없음) |
| 스캔↔TF 지연 | `ros2 topic delay /scan` | `lookup_transform_timeout_sec=0.2` 초과분이 버려진다 |

---

## 7. 검증 상태 — **실기 미검증**

```
python -m ast  : real_robot_driver_260519.py / real_robot_260519.launch.py
                 odom_calibrate.py / hardware_test.py / odom_check.py   → 문법 OK
bash -n        : scripts/robot-up.sh                                    → 문법 OK
grep           : odom→base_link TF 발행자 중복 없음 확인
```

윈도우 PC 에서 작업했고 **젯슨은 전원이 꺼져 있었다.** `colcon build` 도 노드 기동도
하지 못했다.

---

## 7.5 저장소 정리 — `old_file/` 신설

모터 관련 코드 사본이 여러 벌이라 "지금 실제로 도는 게 어느 것인지" 가 헷갈렸다.
**지우지 않고 `old_file/<원래 경로>` 로 옮겼다.** 원래 경로를 그대로 유지하므로
`old_file/` 만 떼면 복구된다. `COLCON_IGNORE` 를 넣어 빌드에서 제외했다.

옮긴 것: `ddsm_python/` 전체(벤더 예제 + 옛 드라이버 사본), `main_loop.py` /
`ReferenceGenerator.py`(죽은 코드 — `communication` 모듈이 저장소에 없다),
일회성 테스트 노드 4개, 안 쓰는 launch 3개 + `display.rviz` + `my_slam_params.yaml`,
루트 산출물(`frames_*`, `.xcf`, `.png`)과 1회성 스크립트 2개. **총 30개.**

> ⚠️ **`TubeMPCPlanner.py` 는 옮기면 안 된다.** `bridge_node.py` 가 sys.path 에
> `src/ddsm_example/mpc_tubempc` 를 넣고 가져오므로 **경로가 코드에 박혀 있다.**
> 펌웨어 소스(`*.ino`, `json_cmd.h`)도 남겼다 — 프로토콜 의심 시 정본이다.

옮기지 않은 것: `sllidar_ros2/`(서드파티, 업스트림과 어긋나면 갱신이 괴롭다),
루트 `.md`(에이전트 지시문), `relayrobot_driver/` 패키지 자체(엔트리가 살아 있다).

**활성 파일 지도는 `README.md` 의 "파일 구조"** 절에 읽는 순서까지 같이 넣었다. 무엇을 왜 옮겼는지는 `old_file/README.md`.

> `README.md` 안에 옮긴 파일의 **실행 경로가 박혀 있었다.** `old_file/` 접두어를
> 붙여 고쳤다. 파일을 옮길 때는 문서의 명령어 경로도 같이 봐야 한다.

### `relayrobot_driver` 패키지 폐지 — 중복 노드 통합

`odom_sub`(`odom_subscriber.py`)와 `relayrobot_description` 의 `odom_listener` 가
**완전히 같은 일**을 했다(둘 다 `/odom` 구독 → x, y, yaw 출력). 패키지 하나가 그
중복 노드 하나 때문에 존재하고 있었다. `odom_listener` 로 합치고 패키지는 보관소로.

합치면서 `odom_sub` 쪽 장점 두 개를 가져왔다:
- 출력을 `print` → `get_logger()` (ROS 로그에 남고 시각이 찍힌다)
- `destroy_node()` 를 `finally` 안으로 (예외 시에도 정리)

**워크스페이스 패키지가 6개 → 5개가 됐다.** 기존 문서의 "6/6 성공" 은 옛말이다.

> ⚠️ **젯슨에 `install/relayrobot_driver/` 가 남아 있으면** `ros2 run relayrobot_driver
> odom_sub` 가 낡은 사본으로 계속 돈다. pull 후 `rm -rf build install log` 하고
> 다시 빌드하는 게 깔끔하다.

### 문서 감사 — 낡은 내용 정리

새 구성과 어긋나는 서술을 훑어서 고쳤다.

| 문서 | 무엇이 틀렸나 |
|---|---|
| `README.md`(구 `README_ROBOT.md`) | **OS/ROS 가 `Ubuntu 24.04` / `ROS2 Jazzy` 로만 적혀 있었다.** 로봇은 JetPack 6.2.1 = **Ubuntu 22.04 = Humble** 이다. 설치 단계의 `ros-jazzy-*` 를 그대로 따라 하면 **패키지를 못 찾는다.** 젯슨/PC 구분 표로 교체 |
| `README.md`(구 `README_ROBOT.md`) | 포트 매핑이 `/dev/ttyACM0`, 라이다 `A3` → udev 별명 `/dev/motor`, **S2 계열** 로 정정 |
| `README.md`(구 `README_ROBOT.md`) | STAGE 1 의 `/odom_raw` → `/odom` |
| `README.md` | 최상단에 구성 변경 배너 추가. mermaid·토픽 흐름·토픽 표·TF 트리·STAGE 검증 명령의 `/odom_raw` 와 "EKF 가 TF 를 낸다" 를 조건부로 |
| `README.md` | "colcon build (6개 패키지)" → 5개 |
| `docs/wiki/entities/Relay_Robot_Hardware.md` | IMU 역할이 "EKF 의 yaw 소스" 로만 적혀 있었다 → 선택 사항 명시 |

### README 두 벌을 하나로 합침

`README.md`(1350줄)와 `README_ROBOT.md`(509줄)가 크게 겹치는데 **서로 다른 시점에
갱신돼서 모순이 쌓였다.** 위 표의 "Jazzy/24.04" 오류가 정확히 그 증상이다 —
`README.md` 는 배포판 호환표로 Humble 을 다루고 있었는데 `README_ROBOT.md` 만
Jazzy 로 굳어 있었다. **문서가 둘이면 한쪽만 고치게 된다.**

`README.md` 를 정본으로 삼았다 (상위집합 — STAGE 0~6, 젯슨/PC 터미널 분리,
`robot-up.sh`, `mpc_sim.py` 리허설, 비상정지, QP_FAILED 규명이 전부 이쪽에만 있었다).
`README_ROBOT.md` 의 고유분만 옮기고 `old_file/` 로 보냈다:

- 활성 파일 지도 + 공부할 때 읽는 순서 → `README.md` 의 "파일 구조"
- 젯슨(Humble) / PC(Jazzy) 실제 구성표 → 배포판 호환표 뒤
- 포트 매핑 정정(`/dev/motor`, 라이다 S2/S3)

합치면서 `README.md` 안의 낡은 서술도 같이 고쳤다:

| 위치 | 무엇이 틀렸나 |
|---|---|
| 트러블슈팅 "RViz 떨림" | **"real_robot_driver 의 TF 브로드캐스터는 이미 비활성화됨"** — 이제 반대다. 기본 구성에서 드라이버가 TF 를 낸다. `use_imu` 별 발행자 표로 교체 |
| STAGE 2 / 2-B | IMU 테스트인데 필수처럼 적혀 있었다 → **(선택)** 표시. 기본 구성용 대체 검사(바퀴 회전 부호)를 넣었다 |
| STAGE 4 | 제목이 "Odometry (EKF 융합) 테스트" → "Odometry + TF 테스트". `/odom` 이 10Hz(드라이버)인지 30Hz(EKF)인지도 명시 |
| GUI 절 | "EKF Start 전에 Motor·IMU 가 먼저" → 기본은 Motor Start 만으로 `/odom` 이 나온다. EKF Start 가 막혀 있는 이유도 적었다 |
| apt 설치 | `ros-jazzy-*` 하드코딩 → `ros-$ROS_DISTRO-*` (젯슨 Humble / PC Jazzy 양쪽에서 동작) |
| 포트 매핑 | `RPLidar S3` → **S2/S3 계열** + A1 launch 로는 죽는다는 경고 |

> **교훈: 같은 내용을 두 문서에 두지 않는다.** 한쪽만 갱신되는 순간
> 어느 쪽이 맞는지 알 수 없어지고, 대개 **안 고친 쪽을 먼저 읽게 된다.**

> **교훈: 기본 구성을 바꾸면 문서의 "확인 명령" 부터 깨진다.** 토픽 이름이 바뀌면
> 코드의 구독자뿐 아니라 **문서의 `ros2 topic echo` 도 같이 틀려진다.**

---

## 8. 이날 바뀐 파일

| 파일 | 내용 |
|---|---|
| `relayrobot_description/.../real_robot_driver_260519.py` | `odom_topic`/`publish_tf` 파라미터, `TransformBroadcaster` 로 TF 발행, 타임스탬프 단일화 (3절) |
| `relayrobot_description/launch/real_robot_260519.launch.py` | `use_imu` 인자(기본 false). 드라이버 2벌 조건 분기, `imu_node`/`ekf_node` 를 `IfCondition` 으로 |
| `relayrobot_description/config/my_cartographer.lua` | `ceres_scan_matcher.rotation_weight` 40 → 20 (5절) |
| `relayrobot_description/.../odom_calibrate.py` | `odom_topic` 기본값 `/odom_raw` → `/odom` (4절) |
| `tools/odom_check.py` | `raw_topic` 파라미터 신설(기본 `/odom`), IMU 없을 때 ② 불가 명시 (4절) |
| `gui_py/gui_py/hardware_test.py` | `use_ekf` 파라미터, `_motor_cmd()`, EKF Start 가드, 구독 토픽 분기 (4절) |
| `scripts/robot-up.sh` | `USE_IMU` 환경변수. `/dev/ttyimu` 없어도 기동. nav 모드에 `omega_limit:=0.5` |
| `README.md`(구 `README_ROBOT.md`) | 데이터 흐름도 / TF 트리 / 토픽표 / STAGE 4 갱신 |
| `docs/wiki/concepts/TF_Coordinate_System.md` | `odom→base_link` 발행자가 구성에 따라 다름을 반영 |
| `docs/wiki/concepts/System_Architecture.md` | IMU 선택 구성 + 속도 제약 절 추가 |
| `old_file/` (신설) | 안 쓰는 파일 30개 이동 + `README.md` + `COLCON_IGNORE` (7.5절) |
| `README.md` | 옮긴 파일의 실행 경로에 `old_file/` 접두어. **`README_ROBOT.md` 를 흡수해 유일한 정본이 됨** (7.5절) |
| `README_ROBOT.md` → `old_file/` | README.md 로 합침 |
| `relayrobot_description/.../odom_listener.py` | `odom_sub` 와 통합 (print → get_logger, destroy_node 를 finally 로) |
| `src/relayrobot_driver/` → `old_file/` | 패키지 폐지. 워크스페이스 6개 → **5개** |
| `docs/wiki/concepts/TF_Coordinate_System.md` | `odom→base_link` 발행자가 구성에 따라 다름을 반영 |
| `docs/wiki/entities/Relay_Robot_Hardware.md` | IMU 가 선택 사항임을 명시 |
| `CLAUDE.md` (신설) | 세션 시작 시 자동 로드. **docs 부터 읽으라는 지시 + 젯슨 빌드 미완** |

**`bridge_node.py` / `path_planner.py` 는 건드리지 않았다** — 09-13 이 이미 옳게 고쳤다. (2절)

---

## 9. 다음에 할 일

1. **젯슨 전원 → `git pull` → `colcon build --symlink-install`** ← 여기부터. (맨 위)
2. **USB 장치 연결 확인** — 09-13 기준 전부 빠져 있다. `ls /dev/motor /dev/rplidar`
3. **오도메트리 + TF 검증** (6절) — `tf2_echo odom base_link` 가 이번 작업의 핵심 가설이다
4. **회전 부호 + 라이다 TF 2분 검사** (6절)
5. **첫 매핑** — 5절 속도 규칙. teleop 은 `-p speed:=0.15 -p turn:=0.4`
6. **GUI 원격 조종 확인** — `ssh -X robot "ros2 run gui_py hw_test"`
7. MPC 는 맵이 나온 뒤. 돌리기 전 `map → base_link` TF 존재 확인 필수
8. `max_range` 8.0 → 12.0 검토 (넓은 공간에서 heading 구속이 약할 때만)

### 이월

- URDF 실측 불일치 — 바퀴 간격 `y=±0.0825`(0.165) / `wheel_diameter=0.1` vs 실측 0.22 / 0.065
- `ebimu_publisher.py:49` `frame_id` 기본값이 URDF 에 없는 `imu_link`
  (IMU 를 안 쓰는 지금은 잠복. `use_imu:=true` 로 돌릴 때 다시 문제가 된다)
- 기구학 상수(`r=0.0325` / `base=0.22` / `rpm_scale=600`)는 **확정. 재측정하지 말 것.**
- 전원 12V 재구성 — 모터 최고속도가 절반 이하가 된다. 느리다고 상수를 의심하지 말 것 (09-13 7절)
