jungguck/mobile_robot_proto_type/docs/DEBUG_LOG_2026-09-13.md

# DEBUG LOG — 2026-09-13

**주제:** 오전 — 재가동 점검(원격 연결 / **12V 전원 재구성** / USB 분리 확인)
**주제:** 오후 — **자율주행 체인 코드 정비 + 로봇 없이 리허설 검증** (11절 이후)

> 오전에는 코드를 고치지 않았다. 하드웨어 재구성 준비와 원격 연결 재확인만 했고
> 모터 구동은 또 못 했다 — USB 장치가 전부 빠져 있었기 때문이다 (6절).
>
> 오후에는 **USB 가 빠진 채로 할 수 있는 것**을 전부 했다. SLAM→A\*→MPC 체인의 구멍 3개를
> 메우고, `tools/mpc_sim.py` 로 **로봇 없이 목표 도달까지** 검증했다 (11~14절).

---

## 0. 다음 세션이 이것만 읽으면 되는 요약

- **원격 연결은 전부 정상이다.** `ssh robot` 키 인증 됨, 젯슨 `humble` / `ROS_DOMAIN_ID=0`. (2절)
- **토픽이 안 보이는 것은 DDS 문제가 아니었다 — 젯슨에 노드가 안 떠 있었을 뿐이다.**
  `ROS_STATIC_PEERS` 로 docker0 멀티캐스트 문제도 배제했다. (4절)
- **⚠️ USB 장치가 전부 빠져 있다 — 09-06 대비 회귀.** `lsusb` 에 허브 2개 + 블루투스뿐이고
  `/dev/ttyUSB*` 가 하나도 없다. 이 상태로는 드라이버 노드가 포트를 못 연다. (6절)
- **전원을 12V 로 재구성 중이다.** 젯슨 DC잭 9–20V 범위 안이라 동작은 하지만,
  **모터 최고속도가 절반 이하**가 된다. 느리다고 기구학 상수를 다시 의심하지 말 것. (7절)
- **⚠️ 젯슨 전원을 뽑기 전에 반드시 `sudo shutdown -h now`.** SD카드 부팅이라 라이브로
  뽑으면 카드가 깨진다. 오늘 두 번 다 이 절차로 껐다. (8절)

### 지금 상태 한눈에 (09-07 대비 갱신분)

| 항목 | 상태 |
|---|---|
| 젯슨 전원 / 부팅 | ✅ 켜고 끄기 확인 (현재는 **의도적으로 OFF**) |
| 핑 `172.30.1.45` | ✅ ~5ms, IP 변동 없음 |
| `ssh robot` 키 인증 | ✅ (키는 09-06 부터 이미 등록돼 있었다) |
| 젯슨 ROS | ✅ `humble`, `ROS_DOMAIN_ID=0` — PC(Jazzy)와 일치 |
| PC → 젯슨 토픽 수신 | ⏸ 젯슨에 노드 미기동이라 미확인 |
| **USB 장치 (`/dev/ttyUSB*`)** | ❌ **하나도 없음 — 물리적으로 분리됨** |
| 전원 구성 | 🔄 12V 로 재구성 중 |
| 모터 구동 / 실주행 | ❌ 여전히 미실시 |

---

## 1. 진단은 아래에서 위로 — 오늘 쓴 사다리

"원격이 되나?" 를 한 번에 묻지 않고 **층을 나눠 아래에서 위로** 올라갔다.
어느 층에서 끊겼는지가 곧 원인이기 때문이다.

```
① 핑          ping -c 2 -W 2 172.30.1.45          → ✅ 같은 망에 살아있다
② 포트 22     bash /dev/tcp 로 접속 시도            → ✅ sshd 는 떠 있다
③ SSH 인증    ssh -o BatchMode=yes robot 'echo OK' → ✅ 키 인증 통과
④ 젯슨 ROS    ssh robot 'echo $ROS_DISTRO'         → ✅ humble, DOMAIN=0
⑤ 노드        ssh robot 'ros2 node list'           → ❌ 없음 (미기동)
⑥ USB 장치    ssh robot 'lsusb; ls /dev/ttyUSB*'   → ❌ 없음  ← 진짜 원인
```

**②의 요령:** `nc` 없이 bash 내장 기능으로 포트만 딱 본다.
```bash
timeout 5 bash -c 'cat < /dev/null > /dev/tcp/172.30.1.45/22' && echo OPEN || echo CLOSED
```
포트는 열렸는데 인증만 거부되면 → **네트워크는 정상, 키 문제**로 범위가 좁혀진다.

**③의 요령:** `BatchMode=yes` 를 붙인다. 비밀번호를 절대 묻지 않고 키로만 시도하므로
프롬프트에서 멈추지 않고 성공/실패가 즉시 갈린다. 스크립트·자동화에 필수다.

> 이 사다리 없이 바로 `robot-up.sh` 를 띄웠다면 "왜 노드가 죽지?" 하고 헤맸을 것이다.
> 실제 원인은 여섯 번째 층(USB)에 있었다.

---

## 2. SSH — 키는 이미 등록돼 있었다

첫 시도에서 한 번 거부됐다.

```
frlab@172.30.1.45: Permission denied (publickey,password)
```

`ssh-copy-id` 를 다시 돌려보니 **이미 등록돼 있다**고 나왔다.

```
WARNING: All keys were skipped because they already exist on the remote system.
```

확인한 사실:

| 항목 | 결과 |
|---|---|
| PC 키 `~/.ssh/id_ed25519` | passphrase **없음** |
| ssh-agent | 동작 중 (`/run/user/1000/keyring/ssh`), 키 로드됨 |
| 젯슨 `~/.ssh/authorized_keys` | 2줄. **2번째 줄이 이 PC 키** — 지문 `SHA256:QiBa1r...` 일치 |

그 뒤로는 계속 정상 접속된다. **첫 거부의 원인은 규명하지 못했다.**
(`ssh -v` 를 그때 안 찍어서 근거가 없다. 추측은 기록하지 않는다.)
재발하면 `ssh -v robot` 의 `Offering public key` / `Authentications that can continue`
줄을 먼저 볼 것.

> `authorized_keys` 1번 줄 `jk-pc` 는 예전 PC/예전 키다. 정리 대상이지만 급하지 않다.

---

## 3. IP 는 양쪽 다 바뀐다 (DHCP)

`ssh -v` 로그 끝에 이런 줄이 있었다.

```
Last login: Sun Sep  6 21:37:59 2026 from 172.30.1.62
```

**9/6 에는 PC 가 `.62` 였고 오늘은 `.44` 다.** 젯슨(`.45`)은 마침 안 바뀌었을 뿐,
같은 이유로 언제든 바뀔 수 있다.

- 젯슨 IP 확인: `ssh robot 'ip -4 addr show wlP1p1s0'` (접속이 되면)
- 접속 자체가 안 되면 → 공유기 관리페이지나 `ping` 스윕으로 새 IP 를 찾고
  `~/.ssh/config` 의 `HostName` 을 고친다.
- **근본 해결은 공유기에서 MAC 고정** (`REMOTE_ACCESS.md` §2-B).

---

## 4. "토픽이 안 보인다" ≠ "DDS 가 안 된다"

PC 에서 `ros2 topic list` 가 `/rosout`, `/parameter_events` 만 뱉었다.
09-07 로그가 경고한 docker0 멀티캐스트 문제를 의심할 상황이었지만, **아니었다.**

**가른 방법 — 탐색을 건너뛰고 젯슨 IP 를 직접 지정한다:**

```bash
export ROS_STATIC_PEERS=172.30.1.45   # 멀티캐스트 탐색 대신 이 IP 로 직접
ros2 daemon stop && ros2 topic list
```

이걸로도 결과가 같으면 **네트워크 문제가 아니라 상대가 아예 발행을 안 하는 것**이다.
실제로 `ssh robot 'ros2 node list'` 가 비어 있었다. 부팅만으로는 노드가 안 뜬다 —
`robot-up.sh` 는 수동 실행이고 tmux 세션도 없었다.

**함께 확인한 함정 — `ros2 daemon stop` 을 빠뜨리지 말 것.**
ROS 2 CLI 는 데몬이 탐색 결과를 캐싱한다. 환경변수를 고쳐도 데몬을 재시작하지 않으면
**옛 결과가 그대로 나와서** 환경이 잘못된 줄 알고 삽질하게 된다.

---

## 5. conda 함정 — 비대화형 셸에서도 똑같다

09-07 로그 3절의 그 문제다. 오늘은 한 가지가 더 확인됐다.

```bash
bash -lc 'conda deactivate; which python3'   # → /home/jk/miniconda3/bin/python3  ❌
```

**비대화형 셸에서는 `conda deactivate` 가 안 먹는다.** conda 훅이 로드돼 있지 않아서
함수 자체가 없기 때문이다. 스크립트 안에서는 PATH 를 직접 잡는 쪽이 확실하다.

```bash
export PATH=/usr/bin:/usr/local/bin:/bin:/usr/sbin:/sbin
source /opt/ros/jazzy/setup.bash
which python3        # → /usr/bin/python3  ✅ (3.12)
```

- **대화형 터미널**에서는 `conda deactivate` 로 충분하다 (프롬프트에 `(base)` 가 사라질 때까지).
- **스크립트/자동화**에서는 PATH 를 명시한다.

---

## 6. ⚠️ USB 장치가 전부 빠져 있다 — 09-06 대비 회귀

오늘 젯슨에서 본 `lsusb` 다. 두 번(첫 확인, 재부팅 후) 모두 같았다.

```
Bus 002 Device 002: ID 0bda:0489 Realtek 4-Port USB 3.0 Hub
Bus 001 Device 003: ID 13d3:3549 IMC Networks Bluetooth Radio
Bus 001 Device 002: ID 0bda:5489 Realtek 4-Port USB 2.0 Hub
```

**허브 2개와 블루투스뿐이다.** `/dev/ttyUSB*`, `/dev/ttyACM*` 도 전무하다.

09-06 에는 세 장치가 모두 붙어 udev 별칭까지 잡혀 있었다
(`/dev/motor`, `/dev/rplidar`, `/dev/ttyimu`). **그 사이 물리적으로 분리된 것이다**
(전원 재구성 작업 중). udev 규칙 자체는 젯슨에 남아 있으므로 **다시 꽂으면 별칭도 같이 돌아온다.**

> **허브는 인식되는데 장치가 안 보인다** → 허브 전원은 살아 있고 그 아래가 빈 것이다.
> 의심 순서: ① 모터 보드 전원 ② 허브↔장치 케이블 ③ 업링크만 꽂고 장치는 다른 허브에 물림

**재연결 후 확인 명령:**
```bash
ssh robot 'lsusb; ls -l /dev/ttyUSB* /dev/motor /dev/rplidar /dev/ttyimu'
```

---

## 7. 전원을 12V 로 재구성

문서(`Relay_Robot_Hardware` 전원 절, 2026-09-06 조사)에 비춰 판단한 내용이다.

| 장치 | 허용 입력 | 12V 에서 |
|---|---|---|
| Jetson Orin Nano 개발자킷 | **DC잭 9–20V** (권장 19V) | ✅ 스펙 안. 정상 동작 |
| DDSM400 ×2 | 정격 **25.2V** | ⚠️ 돌긴 돈다. **최고속도 절반 이하** |
| RPLidar / EBIMU | 5V (USB) | — |

**속도 천장이 낮아질 뿐 토크는 그대로다.** 속도상수 15.9 RPM/V 라 무부하 회전수가
400 RPM → 약 190 RPM, 바퀴 선속도 1.36 m/s → 약 0.65 m/s 가 된다.
토크상수(0.3 Nm/A)는 전압과 무관하다.

> ⚠️ **"로봇이 느리다" 로 기구학 상수를 다시 열지 말 것.**
> `wheel_radius=0.0325` / `wheel_base=0.22` / `rpm_scale=600` 은 2026-09-03 확정값이다.

**지켜야 할 것 — 모터와 젯슨의 전원을 합치지 않는다.**
모터 기동·구속 순간 전류가 튀어 레일이 **9V 아래로 떨어지면 젯슨이 브라운아웃으로 리셋**되고,
SD카드 부팅이라 그게 곧 카드 손상이다. 합쳐야만 한다면 12V 기준 **5A(60W) 이상** +
젯슨 입력단 벌크 커패시터.

**USB 재연결 순서 (권장):** 전부 끄기 → USB 전부 꽂기 → 모터 보드 12V → **젯슨 전원 마지막**.
젯슨이 부팅하며 USB 를 훑을 때 장치가 이미 깨어 있어야 포트가 깔끔하게 잡힌다.
(USB 는 GND 핀이 먼저 닿도록 설계돼 있어 핫플러그 자체는 안전하다. 실패하더라도
"안 잡힘" 으로 나타나지 보통 파손되지 않는다.)

**모터 보드는 전원 사이클마다 `{"T":11002,"type":210}` 초기화가 1회 필요하다** —
전원을 새로 넣었으면 반드시 다시 보낼 것 (`DEBUG_LOG_2026-08-22.md`).

---

## 8. ⚠️ 젯슨은 뽑기 전에 반드시 종료한다

젯슨은 **SD카드 부팅**(`/dev/mmcblk0p1`)이라 라이브로 전원을 뽑으면 카드가 깨진다.
과거에 실제로 겪은 사고다.

```bash
ssh robot 'sudo shutdown -h now'     # PC 에서 한 방에
```

`Connection to 172.30.1.45 closed by remote host.` 가 뜨면 정상이다(젯슨이 꺼지는 중).
**실제로 꺼졌는지는 핑으로 확인한다:**

```bash
for i in $(seq 6); do ping -c 1 -W 1 172.30.1.45 >/dev/null 2>&1 \
  && echo "아직 응답" || echo "무응답"; done
```

전부 무응답이면 뽑아도 된다. 오늘 두 번 다 이 절차를 지켰고 카드는 무사하다.

---

## 9. 조작 함정 — 지금 내가 PC 인가 젯슨인가

`ssh robot 'sudo shutdown -h now'` 를 **젯슨 안에서** 쳐서 이 에러가 났다.

```
ssh: Could not resolve hostname robot: Temporary failure in name resolution
```

`robot` 별칭은 **PC 의 `~/.ssh/config` 에만** 있다. 젯슨에는 없다.

| 프롬프트 | 여기가 어디 | 종료 명령 |
|---|---|---|
| `jk@jk:~$` | 내 PC | `ssh robot 'sudo shutdown -h now'` |
| `frlab@frlab:~$` | 젯슨 | `sudo shutdown -h now` (별칭 불필요) |

PC 로 돌아가려면 `exit`.

---

## 10. 다음에 할 일

1. **USB 3개 재연결** → `ssh robot 'lsusb; ls -l /dev/motor /dev/rplidar /dev/ttyimu'`
   로 udev 별칭까지 돌아왔는지 확인. **여기가 지금 유일한 블로커다.**
2. **노드 기동** — `ssh robot '~/mobile_robot_proto_type/scripts/robot-up.sh'`,
   `status` 로 토픽 주기 확인.
3. **PC 에서 DDS 수신 실증** — `ros2 daemon stop && ros2 topic list` 에 젯슨 토픽이 뜨는지.
   (09-06 에 성공한 적 있으므로 재현 확인이다)
4. **⚠️ 실주행 전에 `timer_callback()` 유령 거리 버그부터** — 09-03 부터 이월된 우선순위 1.
   명령 재전송 + `cmd_vel` 타임아웃이 없어서, `odom_check` 비율이 어긋났을 때
   상수 문제인지 stale 피드백 문제인지 구분이 안 된다.
5. **모터 구동 검증** — 보드 전원 사이클 후 `type:210` 초기화 → `odom_check` 켜놓고
   살살 굴리며 선속도/회전 스케일 비율 확인. **12V 라 느린 것은 정상이다.**

---

# (오후) 자율주행 체인 코드 정비

## 11. 조사 결론 — 없는 것은 코드가 아니었다

"MPC 주행하려면 파일이 어디까지 있어야 하나" 를 조사한 결과다.

| 체인 단계 | 파일 | 코드 | 실기 |
|---|---|---|---|
| 모터 + 휠 odom | `real_robot_driver_260519.py` | ✅ | ❌ |
| IMU / LiDAR | `ebimu_publisher.py` / `sllidar_ros2` | ✅ | ✅ (09-06) |
| EKF | `config/ekf.yaml` + launch | ✅ | ❌ |
| SLAM | `cartographer.launch.py` + `my_cartographer.lua` | ✅ | ❌ |
| A* | `path_planner.py` | ✅ | ❌ |
| Tube-MPC | `bridge_node.py` + `TubeMPCPlanner.py` | ✅ | ❌ |

**SLAM 을 돌리는 데 새로 만들 파일은 0개다.** `real_robot_260519.launch.py` 하나가
모터·IMU·LiDAR·EKF 를 전부 띄우고, 거기에 `cartographer.launch.py` 만 얹으면 된다.

문제는 **SLAM 을 켜는 순간 깨지는 구멍 3개** 와, **원격에서 "잘 가고 있다" 를 볼 수단이
없다**는 것이었다.

## 12. 고친 것 4가지

### 12-1. `/cmd_vel` watchdog + 피드백 stale 차단 (09-03 부터 이월된 1순위)

`cmd_vel_callback` 이 받는 즉시 `drive()` 하고 끝났다. DDSM 은 **명령 유지형**이라
MPC 가 죽거나 무선이 끊겨도 로봇이 계속 간다. 그리고 `read_feedback()` 은 새 프레임이
안 와도 직전 rpm 을 영원히 들고 있어서 **멈춘 로봇이 odom 상으로는 계속 전진**했다.

- `motor_drive_1.py`: `last_feedback_time` + `feedback_age()` 추가.
  매 프레임 찍히던 `print("Debug faw data")` 제거 (터미널 폭주 + 시리얼 루프 지연)
- `real_robot_driver_260519.py`: `cmd_vel` 은 **저장만** 하고 10Hz 타이머가 **매 사이클 재전송**.
  `cmd_timeout`(0.5s) 넘으면 0, `feedback_timeout`(0.3s) 넘으면 속도를 0 으로 간주

> 재전송이 stale 자체를 씻어낸다 — `drive()` 안에서 `read_feedback()` 이 매 주기 돌기 때문.

### 12-2. A* 장애물 팽창 + 미탐색 차단

`is_free()` 가 `value == -1 or value < 50` 이었다. 셀 하나만 보니 **로봇 몸통이 벽을 긁는
경로**가 나오고, **미탐색(-1)을 통행 가능으로 취급해 지도 밖으로 경로를 뚫었다.**

`scipy.ndimage.distance_transform_edt` 로 지도가 올 때 **한 번만** 팽창을 계산한다
(계획마다 다시 하지 않는다). `robot_radius`(0.20) + `inflation_margin`(0.05).
결과를 `/inflated_map` 으로 발행 — **PC RViz 에서 "왜 경로가 안 나오는지" 를 눈으로 본다.**

벽 가까이 있을 때 시작 셀이 막혀 계획 자체가 실패하는 걸 막으려고,
반경 안에서 가장 가까운 자유 셀로 대체하는 폴백을 넣었다.

### 12-3. ★ tf2 로 `map` 프레임 일원화 — SLAM 켜는 순간 터지는 구멍

`bridge_node` 는 `/odom`(**odom 프레임**) 위치를 쓰는데 `/global_path` 와 `/mpc_goal` 은
**map 프레임**이었다. 두 노드 어디에도 tf2 import 가 없었다 — 변환 없이 그냥 뺐다.
**Cartographer 가 드리프트를 보정한 만큼(map→odom)이 그대로 추종 오차로 둔갑한다.**

두 노드 모두 `global_frame`(기본 `map`) → `base_link` TF 로 현재 위치를 받게 고쳤다.
`-p global_frame:=odom` 으로 내리면 SLAM 없이도 그대로 돈다.

### 12-4. `/mpc/*` 원격 관측 토픽 — 원격 운영의 전제

MPC 상태가 `get_logger().info` 한 줄뿐이라 **젯슨 tmux 안에 갇혀 있었다.**
제어 루프는 젯슨에서 돌아야 하므로(무선 너머 10Hz 는 곧 제어 지터), PC 가 볼 수단이 필요하다.

| 토픽 | PC 에서 |
|---|---|
| `/mpc/reference_path` | RViz — 지금 호라이즌이 어디를 향하는지 |
| `/mpc/tracking_error` | `rqt_plot` — e_act (x, y, θ) |
| `/mpc/status` | `ros2 topic echo` — RUNNING / QP_FAILED / GOAL_REACHED / NO_POSE |

`robot-up.sh` 에 `slam` / `nav` 모드 추가, PC 용 `config/nav.rviz` 신규.

## 13. ★ QP 가 100% 실패하던 진짜 이유 (측정으로 확정)

리허설 첫 주행에서 로봇이 (0.33, 0.14) 까지 가다 멈추고 **12초간 94번 전부 `QP_FAILED`** 였다.

`x_min = [-2.0, -2.0, -0.3]` 의 θ 한계가 원인이다. 이 값은 tube 만큼 타이트닝되어
**실효 0.25 rad(14°)** 가 된다. 그런데 A* 경로를 따라갈 때 첫 참조점의 접선 방향과
로봇의 현재 방향은 출발 시 쉽게 20~30° 벌어진다 → **첫 사이클부터 제약 위반 → 항상 infeasible.**

추측으로 두지 않고 오프라인으로 재현해 경계를 쟀다:

```
타이트닝된 상태상한 x_b : [1.95 1.95 0.25 ...]
  e_theta=0.20 rad -> OK
  e_theta=0.25 rad -> OK
  e_theta=0.30 rad -> FAIL     ← 경계가 정확히 0.25
  e_theta=0.43 rad -> FAIL     ← 실제 주행 중 관측된 값
```

**해결:** `error_yaw_limit` 파라미터로 빼고 기본값을 `3.2`(사실상 무제한)로.
**heading 오차는 안전 제약이 아니다** — 돌아서 줄이면 되는 값이다. 실제로 지켜야 할 것은
위치 오차(tube)이고 그건 `error_xy_limit` 과 ancillary 되먹임이 담당한다.

**QP 부하는 걱정할 수준이 아니다** (젯슨 우려에 대한 답):
변수 8개 / 제약 40행. PC(i5-12400F) 실측 **평균 4.5 ms, 최대 7.3 ms** — 10Hz 예산의 5%.
대부분이 cvxpy 의 파이썬 오버헤드라 젯슨 ARM 에서 몇 배 느려져도 여유가 있다.
**젯슨이 켜지면 같은 스크립트로 실측할 것.**

## 14. 리허설 결과 — 로봇 없이 목표 도달까지

`tools/mpc_sim.py` 신규. 가짜 `/map` 발행 + `/cmd_vel` 을 차동구동으로 적분 +
`map→odom→base_link` TF 발행. **A*/MPC 입장에서는 진짜 로봇과 구분되지 않는다.**

| 검증 | 결과 |
|---|---|
| 빌드 | 6/6 (`--symlink-install`) |
| 의존 import | polytope / cvxpy / osqp / cvxopt / scipy.ndimage ✅ |
| A* 계산 시간 | 61점 경로, **16 ms** |
| 팽창 | 통행가능 셀의 장애물까지 **최소 0.250 m** (기준 >0.25) ✅ |
| 미탐색 차단 | 미탐색인데 통행가능인 셀 **0개** ✅ |
| 경로 여유 | 벽까지 최소 0.950 m ✅ |
| 주행 | (0,0) → 목표 (3.0, 2.0), 도달 **(3.066, 2.004)**, QP 실패 **0회** ✅ |
| **★ 프레임 정합** | `map→odom` 을 (0.5, 0.5, 0.3) 틀어놓고도 도달, QP 실패 0회 ✅ |
| SLAM 없는 모드 | `global_frame:=odom` 직선 추종 도달 ✅ |
| `nav.rviz` | 로드 에러/경고 0 ✅ |

> **도달 오차가 goal_tolerance(0.1)보다 큰 이유:** 도달 판정을 **A* 경로의 마지막 점** 기준으로
> 한다. 그 점은 격자 중심이라 목표에서 최대 반 셀(0.025m) 어긋나 있다. 정상 동작이다.

### 빌드 잔여물 하나 치움

`colcon build` 가 실패했다. 6월에 지운 `real_robot.launch.py` 의 **끊긴 심볼릭 링크**가
`build/` 와 `install/` 에 남아 있었다 (`--symlink-install` 의 흔적).

```bash
find build install -xtype l      # 끊긴 링크 찾기
```

내 변경과 무관한 오래된 잔여물이다. 같은 증상이 또 나오면 이 명령부터 볼 것.

## 15. README 실행 가이드 재편 — 단계 게이트 + 터미널 표기

지금까지 "터미널 1/2/3" 이라고만 써 있어서 **그게 PC 인지 젯슨인지가 문서에 없었다.**
원격 운영이 기본이 된 이상 이건 실수를 부른다 (9절에서 실제로 헷갈린 적 있음).

- **터미널 표기 규칙 신설** — 모든 명령 앞에 `[PC-n]` / `[젯슨-n]` 을 붙였다.
  README 의 옛 `[터미널 n]` / `SSH 창 n` 표기는 전부 치환했다 (남은 것 0개)
- **진행 순서 표 신설** — 단계 / 쓰는 터미널 / **통과 기준** / 실패 시 돌아갈 곳.
  한 단계를 통과해야 다음으로 간다는 걸 표로 못 박았다
- **STAGE 0 신설** (USB·전원·**시계 동기**), **STAGE 2-B 신설** (IMU yaw 방향),
  **STAGE 4-B 신설** (watchdog), **STAGE 5.5 신설** (리허설)

## 16. STAGE 2-B 를 왜 따로 뺐나 — IMU yaw **부호**

`ekf.yaml` 은 **방향을 IMU 하나에만 맡긴다** (`imu0_config` 의 yaw 만 true, 바퀴 yaw 는 전부 false).
그래서 **IMU yaw 부호가 반대면 EKF 가 진행 방향을 거울로 뒤집어 적분**하고, 그 `/odom` 이
그대로 SLAM prior 로 들어가 지도가 통째로 망가진다.

**크기가 아니라 부호 문제라 값만 봐서는 눈치채기 어렵다.** 그래서 회전을 직접 시켜 확인한다.
ROS 규약(REP-103)은 반시계(왼쪽) 회전이 +z 다.

**교차 검증 수단이 이미 있다:** `tools/odom_check.py` 의
**② 회전 스케일 = `raw_Δθ / imu_Δyaw`** 가 **음수(≈ −1.0)면 부호 불일치**다.
크기는 맞는데 부호만 틀린 경우를 정확히 잡아낸다.
`rqt_plot /odom_check/raw_theta_deg /odom_check/imu_dyaw_deg` 로 두 곡선이 같은 방향으로
움직이는지 겹쳐 보면 눈으로도 확인된다.

부호가 반대면 `ebimu_publisher.py` 의 `timer_callback()` 에서 `yaw = -yaw` 한 줄.

## 17. 코드 리뷰에서 잡힌 것 — 안전 결함 1건 포함

작성한 코드를 `/code-review high` 로 다시 훑었다. **10건 중 8건을 고쳤다.**

### ★ 17-1. 경로가 없으면 장애물로 직진했다 (HIGH — 안전)

`robot-up.sh nav` 가 쓰는 조합(`use_goal_topic` + `use_global_path`)에서,
`/mpc_goal` 은 즉시 `goal_pose` 에 들어가는데 `/global_path` 는 아직 없을 수 있다
(계획기 기동 전, 계획기 사망, **A\* 실패**). 그때 옛 코드는 `_generate_reference()` 로
**목표까지 직선 참조**를 만들어 그대로 달렸다 — **지도를 전혀 안 보고.**

A\* 가 "경로 없음"·"목표가 막힘" 으로 실패한 상황이 곧 이 상황이다.
즉 **갈 수 없다고 판정된 목표를 향해 장애물을 뚫고 직진**한다.

→ 경로 추종 모드에서 경로가 없으면 **선다**(`/mpc/status = NO_PATH`, 정지 명령).

**실증:** 장애물 한가운데(1.7, 0.5)를 목표로 주었더니
`Goal cell is not free` → 빈 경로 → `NO_PATH`, `cmd_vel.x = 0.0`, **로봇 안 움직임.**

### 17-2. 낡은 경로를 영원히 붙들었다 (HIGH)

`global_path` 에 수명이 없어서, 계획기가 죽거나 지도에 새 장애물이 생겨도
옛 경로를 계속 `RUNNING` 으로 따라갔다.
→ 계획기가 **실패 시 빈 경로를 발행**하고, MPC 는 `path_timeout`(2s) 넘은 경로를 버린다.

### 17-3. 참조 궤적이 속도 한계의 5~7배로 달아났다 (HIGH)

`step_len = max_v * 0.1` 은 0.01~0.02m 인데 `_advance_along_path` 가 **셀 단위로 스냅**해서
한 스텝에 최소 한 셀(0.05m, 대각 0.07m)을 통째로 넘어갔다. 결과:
**(a)** 예측 모델과 참조가 서로 안 맞고, **(b)** `uRef[0]` 이 항상 `max_v` 에 붙어
**경로가 옆으로 꺾여도 전속 전진 명령**이 나갔다(제자리 회전 대신 튀어나감).
→ 세그먼트 안에서 **보간**(`_path_pose_at`)하도록 교체.

### 17-4. 그 밖에 고친 것

| # | 내용 |
|---|---|
| 17-5 | **TF lookup 에 timeout 을 주면 안 된다** — `rclpy.spin` 은 단일 스레드라 그 함수가 자는 동안 `/tf` 가 배달되지 않는다. 성공할 수 없는 대기로 제어 주기만 잡아먹는다 → `timeout` 제거 |
| 17-6 | `nearest_free` 가 **벽 건너편 셀로 시작점을 옮길 수 있었다** (팽창 지름 0.5m 보다 얇은 벽). 원본 장애물 기준 **가시선 검사** 추가 |
| 17-7 | A\* 에 **전개 상한**(`max_expansions`) — 도달 불가능한 목표를 주면 자유 공간 전체를 매 주기 훑어 `map_callback` 과 TF 수신까지 멈췄다 |
| 17-8 | **`nav` 모드의 비상정지 안내가 틀렸다.** MPC 가 10Hz 로 계속 쏘므로 "발행을 멈춘다" 가 성립하지 않는다 → `tmux kill-window -t robot:mpc` 로 정정 |
| 17-9 | 목표 `header.frame_id` 가 `global_frame` 과 다르면 경고 |
| — | `e_nom` 을 **실제로 낸 보정량**으로 전파 (QP 입력집합 ±0.5 vs 속도한계 0.1 불일치로 명목 상태가 현실과 벌어졌다) |

**안 고친 것:** `gui_control.py` — Trossen 로봇팔 Tkinter 컨트롤러다. 이 저장소와 무관한
다른 워크스페이스 파일이 섞여 들어온 것으로 보여 **커밋하지 않았다.**

### 재검증 (리뷰 수정 후)

| 항목 | 결과 |
|---|---|
| 목표 (3.0, 2.0) 주행 | 도달 **(3.038, 2.038)** — 수정 전 6.6cm → **5.4cm**, 과주행도 사라짐 |
| QP 실패 | **0회** |
| 목표 발행 전 | `NO_PATH` + `cmd_vel = 0` (예전엔 기본 목표로 `GOAL_REACHED`) |
| **장애물 안 목표** | `NO_PATH`, **안 움직임** ← 17-1 실증 |
| **미탐색 구역 목표** | `NO_PATH`, **안 움직임** |

## 18. 다음에 할 일 (갱신)

**순서대로. 한 단계 통과해야 다음으로 간다.**

| # | 단계 | 터미널 | 통과 기준 |
|---|---|---|---|
| 1 | **USB 3개 재연결** — 여전히 유일한 블로커 | `PC-1` | 심볼릭 링크 3개 ✅ |
| 2 | **STAGE 0: 시계 동기** — 저장소 문서에 NTP 언급이 전무했다 | `PC-1` | 시계 차 < 1s |
| 3 | **STAGE 1: 모터 구동** — 전원 사이클 후 `type:210` 초기화 | `젯슨-1` `PC-1` | 바퀴가 명령에 응답 |
| 4 | **★ STAGE 2-B: IMU yaw 방향** — 16절. 부호 하나가 전체를 뒤집는다 | `젯슨-1` `PC-1` `PC-2` | 왼쪽 회전 → yaw 증가(+) |
| 5 | **★ STAGE 4-B: watchdog 실기 확인** — 리허설로 대체 불가(시리얼 필요) | `젯슨-1` `PC-1` | 0.5초 뒤 자동 정지 |
| 6 | **STAGE 4: odom 캘리브** (`tools/odom_check.py`) | `젯슨-1` `PC-1` | 선속도·회전 스케일 0.9~1.1 |
| 7 | **STAGE 5: SLAM** — **코드 작업 0** | `젯슨-1,2` `PC-1~3` | `map→odom` 발행 |
| 8 | **STAGE 6: 자율주행** — `robot-up.sh nav` | 젯슨 tmux + `PC-1~4` | 목표 도달 |
| — | **젯슨에서 QP 실측** — 13절 스크립트 그대로 | `젯슨-1` | 100ms 예산 내 |

> 12V 라 느린 것은 정상이다. **느리다고 기구학 상수를 다시 열지 말 것** (09-03 확정값).
