jungguck/mobile_robot_proto_type/docs/DEBUG_LOG_2026-09-03.md

# DEBUG LOG — 2026-09-03

**주제:** 캘리브레이션 값 확정(8/22 미해결 항목 정리) + Jetson Orin Nano JetPack 6 부팅 실패 + 원격 접속 방침

---

## 0. 다음 세션이 이것만 읽으면 되는 요약

> **이 문서가 현재 상태의 정본이다.** `DEBUG_LOG_2026-08-22.md` 의 "미해결" 목록에는
> 이미 닫힌 항목이 섞여 있으니 그것만 보고 판단하지 말 것.

- **기구학 상수는 전부 확정됐다. 재측정 제안하지 말 것.**
  `wheel_radius = 0.0325` (지름 65mm) / `wheel_base = 0.22` / `rpm_scale = 600`
- 8/22 의 "지름 6.5cm vs 역산 7.4cm 14% 불일치" 는 **무효**다. 근거가 줄자가 아니라
  눈대중이었고, 이후 확인 결과 6.5cm 가 맞다. → **모순은 처음부터 없었다.**
- **아직 안 고친 것은 코드 쪽 3가지뿐**이다. (아래 3절)
- 젯슨은 **Orin Nano 개발자 키트 + JetPack 6.2.1** 를 쓰려 했으나 부팅 실패.
  QSPI 펌웨어가 구버전이라서다. **JetPack 5.1.3 을 bridge 로 거쳐야 한다.** (아래 4절)
- 목표 환경은 **JetPack 6.2.1 = Ubuntu 22.04 = ROS 2 Humble** 이다. (Jazzy 아님)
  셋업 절차 전체는 `docs/JETSON_SETUP.md` 에 있다.

---

## 1. 오늘 왜 시간을 낭비했나 (프로세스 문제)

저장소 최신 커밋이 **2026-08-22**, working tree 는 clean 이었다. 그런데 그 사이
실기에서는 `rpm_scale` 검증도 끝났고 바퀴 지름 6.5cm 도 확인된 상태였다.
**실기 결과가 저장소로 돌아오지 않았다.**

그래서 문서를 근거로 답하면 이미 닫힌 항목을 "재측정 필요" 로 다시 집어들게 된다.
사람이든 LLM 이든 똑같이 걸린다. 오늘 이걸로 한 라운드를 통째로 날렸다.

> **규칙: 실기에서 값이 확정되면 그날 저장소에 반영한다.**
> 커밋 하나가 아까워서 미루면, 다음 세션이 그 몇 배를 다시 쓴다.

---

## 2. 확정 (닫힌 항목 — 다시 열지 말 것)

| 항목 | 확정값 | 근거 |
|---|---|---|
| `wheel_radius` | **0.0325 m** (지름 65mm) | 실측 확인 (2026-09-03) |
| `wheel_base` | **0.22 m** | 실측 확인 (2026-09-03) |
| `rpm_scale` | **600** | 2026-08-22 기준 유효 확인. `cmd`/`spd` 단위 = 0.1RPM |
| 명령 변환 | `calculate_rpms()` × **600** | `motor_drive_1.py` 현재 코드가 맞다 |
| odom 변환 | `/ 600.0` | `real_robot_driver_260519.py` 현재 코드가 맞다 |

**따라서 8/22 미해결 #1 (`wheel_radius` 캘리브레이션) 은 종결.**
명령 쪽과 계측 쪽이 둘 다 600 으로 일치하므로 "10배 어긋남" 상태도 이미 해소돼 있다.

---

## 3. 남은 미해결 (코드 — 오늘 소스로 직접 확인함)

문서가 아니라 코드를 열어서 확인한 것들이다. 캘리브레이션 값과 무관하게 그대로 남아 있다.

1. **유령 거리 — `timer_callback()` 명령 재전송 미적용** *(우선순위 1)*
   `real_robot_driver_260519.py:86` 의 `timer_callback()` 이 `read_feedback()` 만 부르고
   명령을 재전송하지 않는다. 보드는 **명령을 받을 때만** 피드백을 보내므로,
   `cmd_vel` 이 끊기면 `read_feedback()` 이 **직전 rpm 을 계속 반환** → 로봇은 서 있는데
   odom 은 계속 전진한다. `motor_test0822.py` 에만 고쳐져 있고 실제 드라이버엔 미적용.
   - 설계 주의: 마지막 속도를 무한 재전송하면 상위 노드가 죽어도 로봇이 계속 굴러간다.
     **`cmd_vel` 타임아웃(예: 0.5s) 후에는 0 을 재전송**해야 한다. 이러면 아래 3번도 같이 해결된다.
   - 2차 방어선: 피드백 프레임 수신 시각 워치독. N 주기 동안 새 프레임이 없으면 적분을 건너뛴다.

2. **타임스탬프 이중 취득**
   `real_robot_driver_260519.py:133` 이 `odom.header.stamp` 를 `get_clock().now()` 로 다시 부른다.
   105 행에서 dt 계산에 쓴 `current_time` 과 다른 값이다. `current_time` 을 그대로 쓰면 된다.

3. **heartbeat 워치독 미설정** — 노드가 죽어도 로봇이 안 멈춘다. (1번의 타임아웃으로 대체 가능)

4. **`ebimu_publisher.py:49` 의 `frame_id` 기본값이 `imu_link`** 인데 URDF 에 `imu_link` 링크가 없다.
   현재 launch 파일과 GUI 는 `base_link` 로 덮어쓰므로 **지금 당장 터지지는 않는다.**
   다만 `ros2 run ebimu_pkg ebimu_publisher` 를 인자 없이 실행하면 EKF 가 TF 를 못 찾아
   IMU 를 전부 버리고, 현재 `ekf.yaml` 은 yaw 소스가 IMU 단독이라 **`/odom` 의 yaw 가 0 에 고정**된다.
   에러 없이 조용히 그렇게 된다.

5. **문서/주석 잔재 (혼란 유발)**
   - `real_robot_driver_260519.py` 의 `rpm_scale` 주석: "`calculate_rpms()` 는 ×60 기준이라
     여기와 10배 어긋남" → **더 이상 사실이 아니다.** 양쪽 다 600 이다.
   - `README.md` STAGE 4 Step 4: `wheel_base = 0.165` 로 적혀 있으나 실제 코드/실측은 **0.22**.
   - `README.md` STAGE 4 Step 3: `/600.0` 을 `/300.0`·`/900.0` 으로 바꾸라는 안내는
     `rpm_scale` 이 확정된 지금 **따르면 안 된다.**

6. **IMU + 바퀴 융합 직진 테스트 미실시** (8/22 부터 이월)
7. **URDF 실측 불일치** — 바퀴 간격 `y=±0.0825`(0.165) / `wheel_diameter=0.1` 이 실측(0.22 / 0.065)과 다름. CAD 기준값이라 보류 중.
8. **라이다 미연결 상태** (8/22 부터 이월)

---

## 4. Jetson Orin Nano — JetPack 6.2.1 부팅 실패

### 증상
`jetson-orin-nano-devkit-super-SD-image_JP6.2.1` 을 SD 에 구워 부팅하면
**UEFI Interactive Shell** 로 떨어진다. (= UEFI 가 부팅 가능한 장치를 못 찾음)

### 원인
Orin Nano 개발자 키트는 **부트로더(UEFI)를 SD 가 아니라 모듈의 QSPI 플래시에 저장**한다.
SD 에는 커널과 루트파일시스템만 있다. 공장 출하 펌웨어가 35.x(JetPack 5 세대)면
**36.x 인 JetPack 6 SD 이미지를 못 읽는다.** SD 카드를 다시 굽거나 바꿔도 동일 증상.

- 확인법: 부팅 중 **ESC 연타** → UEFI 메뉴 최상단에 펌웨어 버전. `35.x` 면 확진.
- UEFI Shell 에서 `map -r` 로 `FS0:` 가 보이면 카드는 읽히는 것 → 펌웨어 문제 확정.

### 해결 — JetPack 5.1.3 을 bridge 로 (호스트 PC / 리커버리 모드 불필요)

NVIDIA 가 공식 문서화한 microSD-only 경로다. **재부팅 2회**가 필요하다.

**1) JetPack 5.1.3 SD 이미지** (L4T 35.5.0 / Ubuntu 20.04)
```
https://developer.nvidia.com/downloads/embedded/l4t/r35_release_v5.0/jp513-orin-nano-sd-card-image.zip
```
페이지: https://developer.nvidia.com/embedded/jetpack-sdk-513

> NVIDIA 가 2024-05-28 에 이미지를 교체했다(`_b29`). 그 이전 파일은 문제가 있으니 새로 받을 것.
> 64GB 이상 UHS-1 카드에 Balena Etcher 로 굽는다.

**2) 부팅 후 펌웨어 업데이트**
```bash
# 첫 부팅 → 우분투 초기 설정 + 인터넷 연결

sudo systemctl status nv-l4t-bootloader-config   # 업데이트 예약 확인
sudo reboot                                       # [재부팅 1] 펌웨어 업데이트 실행

sudo nvbootctrl dump-slots-info                   # 버전 확인

sudo apt update
sudo apt install nvidia-l4t-jetson-orin-nano-qspi-updater
sudo reboot                                       # [재부팅 2] QSPI 갱신
```

> ⚠️ **두 재부팅 모두, 펌웨어 업데이트 진행 중 전원을 절대 빼지 말 것.** 벽돌이 될 수 있다.
> **19V 정품 어댑터**를 쓸 것 (USB-C 전원은 업데이트 중 전류가 부족할 수 있음).

끝나면 펌웨어가 36.x 가 되고, 처음 구웠던 **JetPack 6.2.1 SD 카드가 그대로 부팅**된다.

### 펌웨어가 이미 36.x 인데도 안 될 때
- **NVMe SSD** 가 꽂혀 있으면 UEFI 부트 순서가 NVMe 를 먼저 시도하다 Shell 로 떨어질 수 있다.
  SSD 를 빼고 SD 만으로 부팅해보거나 Boot Manager 에서 SD 를 1순위로.
- SD 카드 불량/용량 뻥튀기. 64GB 이상 정품 A2 급 + Etcher 의 verify 통과 확인.

### JetPack 5 에 머무를지 6 으로 갈지 → **6 으로 간다**

> ⚠️ **2026-09-03 정정.** 이 절을 처음 쓸 때 "JetPack 6 = Ubuntu 22.04+ → Jazzy → Gazebo 불가"
> 로 적었는데 **틀렸다.** JetPack 6.x 는 24.04 가 아니라 **Ubuntu 22.04** 다 (L4T 36.x).
> 따라서 Jazzy 가 아니라 **Humble** 이고, README 호환표에서 Humble 은 Gazebo 까지 ✅ 다.
> Gazebo 가 안 되는 건 Jazzy(24.04)뿐이며, 이는 JetPack 7 이후의 얘기다.

| | JetPack 5.1.x (Ubuntu 20.04) | **JetPack 6.2.1 (Ubuntu 22.04)** |
|---|---|---|
| ROS 2 | **Foxy** — 2023-05 EOL | **Humble** — LTS, 2027-05 까지 |
| 6개 패키지 빌드 | ✅ | ✅ |
| 실기 파이프라인 | ✅ | ✅ |
| **Gazebo 시뮬레이션** | ✅ | ✅ |
| Super 모드(MAXN 성능) | ❌ | ✅ |
| ROS apt 설치 난이도 | 높음 (EOL + 2025-06 키 로테이션) | 낮음 |

**결론: JetPack 6.2.1 + Humble 이 전 항목에서 우위다. Foxy 를 고를 이유가 없다.**
JetPack 5.1.3 은 목적지가 아니라 **QSPI 펌웨어를 올리기 위한 경유지**로만 쓴다.

셋업 절차는 `docs/JETSON_SETUP.md` 참고.

---

## 5. 원격 접속 방침 (PC = Windows 11 → 젯슨)

| 목적 | 방법 | 젯슨 부하 |
|---|---|---|
| 명령 실행 | SSH + **tmux** | 없음 |
| 코드 편집 + 터미널 다중 | **VS Code Remote-SSH** | 중간 |
| 기존 `hw_test` GUI 띄우기 | `ssh -X` (X11 포워딩) | 낮음 |
| 지도/스캔/TF 보기 | **Foxglove Studio** | 낮음 |
| 우분투 데스크톱 전체 | NoMachine / VNC | **높음 — 비권장** |

### 채택
```
평소 작업     : VS Code Remote-SSH   (Ubuntu 20.04·22.04 모두 지원됨)
하드웨어 점검 : ssh -X  +  ros2 run gui_py hw_test
SLAM 모니터링 : Foxglove Studio + foxglove_bridge
전체 데스크톱 : 안 씀
```

### 근거
- **tmux 는 선택이 아니라 필수.** detach 해두면 무선 연결이 끊겨도 ROS 노드가 안 죽는다.
  그냥 SSH 로 띄우면 연결이 끊기는 순간 주행 중에 드라이버가 같이 죽는다.
  ```bash
  tmux new -s robot     # Ctrl-b % 좌우분할 / Ctrl-b " 상하분할 / Ctrl-b d 분리
  tmux attach -t robot
  ```
- **`hw_test` GUI 는 tkinter** 라 OpenGL 을 안 쓴다 → X11 포워딩으로 잘 넘어오고 대역폭도 적게 쓴다.
  Windows 쪽에 X 서버(VcXsrv 또는 MobaXterm)만 있으면 된다.
- **RViz2 를 젯슨에서 띄워 화면을 스트리밍하는 건 최악의 조합.**
  젯슨이 렌더링과 영상 인코딩을 둘 다 하게 되어 SLAM 에 쓸 CPU 를 뺏긴다.
  대신 젯슨은 데이터만 보내고 PC 가 그린다:
  ```bash
  sudo apt install ros-$ROS_DISTRO-foxglove-bridge
  ros2 launch foxglove_bridge foxglove_bridge_launch.xml
  ```
  Windows 에서 Foxglove Studio → `ws://<젯슨IP>:8765`. **Windows 에 ROS 설치 불필요.**
- **NoMachine/VNC 함정**: 모니터 미연결(헤드리스) 상태면 X 세션이 없어 **검은 화면**만 나온다.
  HDMI 더미 플러그나 가상 디스플레이 설정이 따로 필요하다.

### SSH 초기 설정 (1회)
```powershell
# Windows 11 은 OpenSSH 기본 탑재
ssh-keygen -t ed25519
type $env:USERPROFILE\.ssh\id_ed25519.pub | ssh <user>@<IP> "mkdir -p ~/.ssh && cat >> ~/.ssh/authorized_keys"
```
`C:\Users\<사용자>\.ssh\config`:
```
Host robot
    HostName <젯슨 IP>
    User <user>
    ServerAliveInterval 30
```
→ 이후 `ssh robot` 만. `ServerAliveInterval` 은 무선 유휴 연결 끊김을 막는다.

---

## 6. 다음에 할 일 (우선순위)

1. 젯슨 JetPack 5.1.3 부팅 → 펌웨어 업데이트 2단계 완료
2. `timer_callback()` 명령 재전송 + `cmd_vel` 타임아웃 → 0 재전송 (3절 1번)
3. 타임스탬프 정리 + `ebimu_publisher` `frame_id` 기본값 (3절 2·4번)
4. 3절 5번의 잔재 주석/README 정리
5. IMU + 바퀴 융합 직진 테스트 (8/22 이월)
6. 라이다 연결 후 Cartographer
