jungguck/mobile_robot_proto_type/src/relayrobot_description/relayrobot_description/real_robot_driver_260519.py

import rclpy
from rclpy.node import Node
from geometry_msgs.msg import Twist, TransformStamped
from nav_msgs.msg import Odometry
from sensor_msgs.msg import JointState, Imu
from tf2_ros import TransformBroadcaster
from tf_transformations import quaternion_from_euler, euler_from_quaternion
import math
import numpy as np

from .motor_drive_1 import MotorDriver


class RealRobotDriver260519(Node):
    """
    역할: 모터 시리얼 통신 + 바퀴 오도메트리 계산

    발행 토픽:
      <odom_topic>  → 바퀴 인코더 오도메트리 (기본 /odom)
      TF odom→base_link → publish_tf=True 일 때만
      /joint_states → robot_state_publisher가 구독해서 RViz 바퀴 시각화
    구독 토픽:
      /cmd_vel     → MPC 또는 teleop에서 속도 명령 수신

    [2026-09-22] IMU 는 선택이 되었다. 구성은 launch 의 use_imu 가 고른다:

      IMU 없음 (기본)  odom_topic=odom,     publish_tf=True
                       → 이 노드가 /odom 과 TF 를 직접 낸다. EKF 불필요.
                         yaw 드리프트는 cartographer 의 scan matching 이
                         map→odom 으로 흡수한다.

      IMU 사용         odom_topic=odom_raw, publish_tf=False
                       → EKF 가 /odom_raw + IMU 를 융합해 /odom 과 TF 를 낸다.

    ★ odom→base_link TF 발행자는 시스템에 하나뿐이어야 한다. 둘이 동시에 쏘면
      TF 가 두 값 사이에서 튀고 원인 추적이 매우 어렵다.
    """

    def __init__(self):
        super().__init__('real_robot_driver_260519')

        # 실측: 바퀴 지름 65mm(r=0.0325), 양 바퀴 중심간 거리 220mm
        # 캘리브레이션 중에는 재빌드 없이 --ros-args -p 로 바로 바꿀 수 있도록 파라미터화
        self.declare_parameter('port', '/dev/motor')
        self.declare_parameter('wheel_radius', 0.0325)
        self.declare_parameter('wheel_base', 0.22)
        self.declare_parameter('rpm_scale', 600.0)

        # 안전 타임아웃. DDSM 은 "명령 유지형" 이라 /cmd_vel 이 끊겨도 마지막 속도로
        # 계속 굴러간다 -> 상위 노드(MPC)가 죽거나 무선이 끊기면 로봇이 안 선다.
        self.declare_parameter('cmd_timeout', 0.5)
        # 피드백이 이만큼 끊기면 current_rpm_* 는 유령값으로 보고 속도 0 으로 취급한다.
        self.declare_parameter('feedback_timeout', 0.3)

        # [2026-09-22] IMU/EKF 를 안 쓰는 구성에서는 이 노드가 odom 토픽과 TF 를
        # 모두 책임진다. EKF 를 붙일 때는 launch 가 use_imu:=true 로 뒤집는다.
        self.declare_parameter('odom_topic', 'odom')
        self.declare_parameter('publish_tf', True)

        port              = self.get_parameter('port').value
        self.wheel_radius = self.get_parameter('wheel_radius').value
        self.wheel_base   = self.get_parameter('wheel_base').value
        self.rpm_scale    = self.get_parameter('rpm_scale').value
        self.cmd_timeout      = float(self.get_parameter('cmd_timeout').value)
        self.feedback_timeout = float(self.get_parameter('feedback_timeout').value)
        self.odom_topic       = self.get_parameter('odom_topic').value
        self.publish_tf       = self.get_parameter('publish_tf').value

        try:
            # 명령/오도메트리가 같은 기구학 상수를 쓰도록 드라이버에 그대로 주입
            self.driver = MotorDriver(port=port,
                                      wheel_radius=self.wheel_radius,
                                      wheel_base=self.wheel_base)
            if self.driver.ser is None:
                raise Exception("Serial connection returned None")
            self.get_logger().info("DDSM400 Motor Connected Successfully!")
        except Exception as e:
            self.get_logger().error(f"Motor connection failed: {e}")
            self.driver = None

        self.get_logger().info(
            f"kinematics: r={self.wheel_radius} m, base={self.wheel_base} m, "
            f"rpm_scale={self.rpm_scale}"
        )

        # 적분으로 누적되는 위치 (노드 시작 시 0으로 초기화)
        self.x     = 0.0
        self.y     = 0.0
        self.theta = 0.0

        self.left_wheel_angle  = 0.0
        self.right_wheel_angle = 0.0
        self.joint_names = ['left_wheel_joint', 'right_wheel_joint']

        self.last_time = self.get_clock().now()

        # /cmd_vel 은 저장만 하고 실제 시리얼 송신은 타이머가 전담한다(아래 timer_callback).
        # 콜백에서 바로 쏘면 타이머의 송신과 시리얼을 두고 경합한다.
        self.cmd_v = 0.0
        self.cmd_w = 0.0
        self.last_cmd_time = None    # None = 아직 한 번도 안 받음
        self.cmd_timed_out = False   # 두절 경고를 한 번만 찍기 위한 래치

        # [2026-09-22 이전] 토픽 이름이 'odom_raw' 고정이었다. EKF 가 /odom 을
        #   내던 시절의 코드다.
        #       self.odom_pub = self.create_publisher(Odometry, 'odom_raw', 10)
        # 순수 바퀴 인코더 odom. 이름은 구성에 따라 바뀐다 (odom / odom_raw).
        self.odom_pub  = self.create_publisher(Odometry,   self.odom_topic, 10)
        self.joint_pub = self.create_publisher(JointState, '/joint_states', 10)

        # TF 발행자는 시스템에 하나뿐이어야 한다. EKF 를 쓰면 여기서 만들지 않는다.
        self.tf_broadcaster = TransformBroadcaster(self) if self.publish_tf else None

        self.subscription = self.create_subscription(
            Twist, 'cmd_vel', self.cmd_vel_callback, 10
        )

        # 10Hz: 시리얼 레이턴시(10ms)와 맞춘 주기
        self.timer = self.create_timer(0.1, self.timer_callback)
        self.get_logger().info(
            f"Real Robot Driver Started (Wheel Odom Only) — "
            f"odom_topic=/{self.odom_topic}, publish_tf={self.publish_tf}"
        )

    def cmd_vel_callback(self, msg):
        # 저장만 한다. 송신은 timer_callback 이 10Hz 로 재전송한다.
        self.cmd_v = msg.linear.x
        self.cmd_w = msg.angular.z
        self.last_cmd_time = self.get_clock().now()

    def timer_callback(self):
        if not self.driver:
            return

        now = self.get_clock().now()

        # ── 1) /cmd_vel watchdog ──────────────────────────────────────────────
        # 명령이 낡으면 0 으로 강제한다. 상위 노드가 죽든 무선이 끊기든,
        # cmd_timeout 안에 로봇이 선다. 비상정지는 "명령을 멈추는 것" 으로 충분하다.
        if self.last_cmd_time is None:
            cmd_age = float('inf')
        else:
            cmd_age = (now - self.last_cmd_time).nanoseconds / 1e9

        if cmd_age > self.cmd_timeout:
            # 기동 직후(명령을 한 번도 안 받은 상태)는 경고할 일이 아니다.
            if not self.cmd_timed_out and self.last_cmd_time is not None:
                self.get_logger().warn(
                    f'/cmd_vel 두절 {cmd_age:.2f}s > {self.cmd_timeout}s -> 정지')
                self.cmd_timed_out = True
            cmd_v, cmd_w = 0.0, 0.0
        else:
            self.cmd_timed_out = False
            cmd_v, cmd_w = self.cmd_v, self.cmd_w

        # ── 2) 매 사이클 재전송 ───────────────────────────────────────────────
        # 유지형이라 한 번만 보내도 돌지만, 재전송해야 (a) 위에서 만든 0 이 실제
        # 하드웨어까지 가고 (b) drive() 안의 read_feedback() 이 매 주기 돌아
        # 피드백이 신선하게 유지된다.
        self.driver.drive(cmd_v, cmd_w)

        # read_feedback() 이 하드웨어 장착 부호(DIR_L/DIR_R)를 이미 흡수해서
        # "+ = 로봇 전진" 으로 돌려준다. 여기서 다시 뒤집으면 안 된다.
        rpm_L, rpm_R = self.driver.read_feedback()

        # ── 3) 피드백 stale 차단 (유령 거리) ──────────────────────────────────
        # MotorDriver 는 새 프레임이 안 와도 직전 rpm 을 계속 들고 있다. 그대로
        # 적분하면 멈춘 로봇이 odom 상으로는 계속 전진한다. 09-03 부터의 이월 과제.
        fb_age = self.driver.feedback_age()
        if fb_age > self.feedback_timeout:
            self.get_logger().warn(
                f'모터 피드백 {fb_age:.2f}s 없음 -> 속도 0 으로 간주 (유령 거리 방지)',
                throttle_duration_sec=5.0)
            rpm_L = rpm_R = 0

        # spd 는 RPM 이 아니라 0.1RPM 단위다. 즉 10 RPM = spd 100.
        #
        #   spd ──÷10──▶ RPM ──÷60──▶ rev/s ──×2πr──▶ m/s
        #       └──────── rpm_scale = 10 × 60 = 600 ────────┘
        #
        # 명령 쪽 calculate_rpms() 의 ×600 과 정확히 서로의 역연산이므로 어긋나지 않는다.
        #   0.1 m/s ÷ 2πr(0.2042) = 0.4897 rev/s ×600 → cmd 293
        #   spd 293 ÷ 600 = 0.4883 rev/s ×0.2042    → 0.0997 m/s  (왕복 일치)
        #
        # 2026-09-03 확정값. 이 값을 조정하지 말 것. (docs/DEBUG_LOG_2026-09-03.md 2절)
        # odom 거리가 안 맞으면 이 팩터가 아니라 유령 거리(피드백 stale)를 먼저 의심할 것.
        # 결과: 바퀴 선속도(m/s)
        vl = (rpm_L / self.rpm_scale) * (2 * math.pi * self.wheel_radius)
        vr = (rpm_R / self.rpm_scale) * (2 * math.pi * self.wheel_radius)

        # 차동 구동 기구학: 로봇 중심 선속도 / 각속도
        v     = (vl + vr) / 2.0
        w_enc = (vr - vl) / self.wheel_base

        current_time = now
        dt = (current_time - self.last_time).nanoseconds / 1e9
        self.last_time = current_time

        # RViz 바퀴 회전 시각화용 (제어에는 안 쓰임)
        ang_vel_L = vl / self.wheel_radius
        ang_vel_R = vr / self.wheel_radius
        self.left_wheel_angle  += ang_vel_L * dt
        self.right_wheel_angle += ang_vel_R * dt

        joint_msg = JointState()
        joint_msg.header.stamp = current_time.to_msg()
        joint_msg.name     = self.joint_names
        joint_msg.position = [self.left_wheel_angle, self.right_wheel_angle]
        joint_msg.velocity = [ang_vel_L, ang_vel_R]
        self.joint_pub.publish(joint_msg)

        # 오일러 적분: 현재 방향(theta) 기준으로 x, y 누적
        self.theta += w_enc * dt
        self.x     += v * math.cos(self.theta) * dt
        self.y     += v * math.sin(self.theta) * dt

        self.publish_odom(v, w_enc, current_time)

    def publish_odom(self, v, w, current_time):
        q = quaternion_from_euler(0, 0, self.theta)

        odom = Odometry()
        # [2026-09-22] 이전에는 여기서 get_clock().now() 를 "다시" 불렀다.
        #   timer_callback 이 dt 계산에 쓴 current_time 과 다른 값이라, odom 메시지와
        #   TF 가 서로 다른 시각을 갖게 된다. IMU 없이 scan matching 에만 의존하는
        #   지금은 cartographer 가 그 차이를 자세 오차로 받아들인다.
        #   (DEBUG_LOG_2026-09-03 3절 2번)
        stamp = current_time.to_msg()
        odom.header.stamp    = stamp
        odom.header.frame_id = "odom"       # 기준 좌표계
        odom.child_frame_id  = "base_link"  # 로봇 몸통

        odom.pose.pose.position.x    = self.x
        odom.pose.pose.position.y    = self.y
        odom.pose.pose.orientation.x = q[0]
        odom.pose.pose.orientation.y = q[1]
        odom.pose.pose.orientation.z = q[2]
        odom.pose.pose.orientation.w = q[3]

        odom.twist.twist.linear.x  = v
        odom.twist.twist.angular.z = w

        # covariance: 이 오도메트리를 얼마나 믿어도 되는지 알려주는 값.
        # IMU 없는 구성에서는 cartographer 의 pose extrapolator 가 참고한다.
        # 값이 클수록 불확실 → scan matching 결과를 더 크게 반영
        odom.pose.covariance = [
            0.05, 0.0, 0.0, 0.0, 0.0, 0.0,
            0.0, 0.05, 0.0, 0.0, 0.0, 0.0,
            0.0, 0.0, 0.05, 0.0, 0.0, 0.0,
            0.0, 0.0, 0.0, 0.01, 0.0, 0.0,
            0.0, 0.0, 0.0, 0.0, 0.01, 0.0,
            0.0, 0.0, 0.0, 0.0, 0.0,  0.1,
        ]
        odom.twist.covariance = odom.pose.covariance[:]

        self.odom_pub.publish(odom)

        # [2026-09-22 이전] 여기가 주석 한 줄이었다:
        #     # TF(odom→base_link)는 ekf_node가 담당 — 여기서 발행하면 이중 충돌
        #   맞는 말이지만, 그래서 IMU 를 빼는 순간 TF 트리가 통째로 끊겼다.
        #   이제 누가 낼지는 publish_tf 가 정한다. EKF 구성에서는 여전히 None 이다.
        if self.tf_broadcaster is None:
            return

        t = TransformStamped()
        t.header.stamp    = stamp
        t.header.frame_id = "odom"
        t.child_frame_id  = "base_link"
        t.transform.translation.x = self.x
        t.transform.translation.y = self.y
        t.transform.translation.z = 0.0
        t.transform.rotation.x = q[0]
        t.transform.rotation.y = q[1]
        t.transform.rotation.z = q[2]
        t.transform.rotation.w = q[3]
        self.tf_broadcaster.sendTransform(t)

    def stop_robot(self):
        if self.driver:
            self.driver.stop()
            self.driver.close()


def main(args=None):
    rclpy.init(args=args)
    node = RealRobotDriver260519()
    try:
        rclpy.spin(node)
    except KeyboardInterrupt:
        pass
    finally:
        node.stop_robot()
        node.destroy_node()
        rclpy.shutdown()


if __name__ == '__main__':
    main()
