jungguck/mobile_robot_proto_type/(commit log)

2026-02-27 중계 로봇 워크스페이스 초기 세팅 및 DDSM 모터 제어 패키지 추가
    [base_link.stl, caserwheel_support_v1_1.stl, casterwhhel_v1_1.stl, left_wheel_v1_1.stl, lidar_v1_1.stl, materials.xacro, model.sdf, relayrobot.xacro]
2026-05-19 docs: 프로젝트 패키지 가이드 및 로봇 연동
2026-05-19 docs: 프로젝트 패키지 가이드, 로봇 연동 매뉴얼 및 자율 주행 시나리오 업데이트
2026-05-20 fix: resolve TF mismatch, enhance GUI stability, and integrate MPC controller
    - Fixed TF tree break by routing /odom_raw through EKF to output /odom.
    - Improved ProcessLauncher in GUI to use process groups for reliable node termination.
    - Added real-time pose tracking to the GUI by subscribing to the /odom topic.
    - Updated MPCController to calculate distance/angle errors for reference tracking.
    - Updated README.md with ROS 2 Humble setup instructions and recent debugging fixes.
    [motor_node_1.py, real_robot_driver_260519.py]
2026-05-22 docs: update README with data flow and hardware setup, optimize motor latency and fix EKF config
    [motor_drive_1.py]
2026-05-22 Refine data flow diagram notation in README
    Updated the data flow diagram in the README to improve clarity and consistency in the notation.
2026-05-26 Add udev rules setup script and fix setup.py data_files
    [base_link.stl, caserwheel_support_v1_1.stl, casterwhhel_v1_1.stl, left_wheel_v1_1.stl, lidar_v1_1.stl, materials.xacro, model.sdf, relayrobot.xacro]
2026-06-14 Add DDSM HAT(B) motor test script and update README with connection notes
2026-06-14 Improve ebimu_publisher and add IMU standalone test scripts
    - Fix YAW wraparound: convert 0~360 to -180~+180 range
    - Add 10s bias calibration on startup for ACC(x,y) and GYRO(z)
    - Fix malformed serial line parsing (strip \r\n, require exactly 9 fields)
    - Add imu_test_1.py: raw IMU value monitor (standalone, no ROS)
    - Add imu_test_2.py: calibrated IMU monitor with EKF-relevant fields only
    [ebimu_publisher.py, imu_test_1.py, imu_test_2.py]
2026-06-14 Fix odom bugs and add MPC+SLAM pipeline docs
    - Fix RPM conversion factor /6.0 -> /600.0 in real_robot_driver_260519.py
    (DDSM400 spd feedback is 10x actual RPM)
    - Add missing left motor feedback sign inversion (rpm_L = -rpm_L)
    without this, forward motion caused robot to spin in place
    - Fix my_slam_params.yaml use_sim_time: true -> false
    - Add README_ROBOT.md: file relationship diagram, topic/TF flow, 6-stage run guide
    - Update README.md, docs/wiki/log.md, Debugging_Experience.md
    [real_robot_driver_260519.py]
2026-06-16 Refactor README and add udev rules file
    - Merge two-part README into single document
    - Rewrite udev section: device identification step + single copy command
    - Add ros_setup alias for both Jazzy and Humble
    - Remove duplicate dialout group setup (not needed with MODE=0666)
    - Add pre-built 99-robot-devices.rules for RPLidar S3 + ebimu + DDSM HAT
2026-06-16 Remove aws-robomaker-hospital-world package
    Gazebo simulation package not needed for real robot operation.
    Excluded from build with --packages-ignore flag.
    [model.sdf]
2026-06-16 Add motor ID setup tool and fix dual-motor ID collision
    - Add motor_id_check.py: query (T:10031) / change (T:10011, sent 5x) motor ID
    DDSM firmware requires the change-ID frame 5 times consecutively to persist
    - Rewrite motor_test_1.py: enable (T:11002) + per-wheel R/L identification
    - Document motor ID setup procedure and the dual-motor collision pitfall
    (changing ID with both motors connected sets them to the same ID)
    [motor_id_check.py, motor_test_1.py]
2026-06-17 Replace gui_py control GUI with hardware test GUI
    Add hardware_test.py (ros2 run gui_py hw_test): a ROS2-based Tkinter
    panel to test Motor / IMU / LiDAR / EKF odometry from one window.
    - Start/Stop each driver node (motor / ebimu / sllidar / ekf) with a
    live ● indicator driven by topic liveness
    - Motor: /cmd_vel jog buttons + speed sliders, /odom_raw feedback
    - IMU: odom-relevant values (yaw, gyro_z, acc_x, acc_y) + calib hint
    - LiDAR: /scan Hz, point count, min/front range
    - Odometry: /odom (EKF-fused) x/y/yaw + v/w for SSH remote monitoring
    - Clean shutdown of launched nodes on window close, SIGHUP/SIGTERM, Ctrl-C
    Add missing setup.cfg so console scripts install to lib/gui_py
    (ros2 r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
2026-06-17 Document hw_test GUI and make driver script commands copy-pasteable
    - Add "통합 테스트 GUI" section for `ros2 run gui_py hw_test`
    (Motor/IMU/LiDAR/EKF odom test, recommended over manual STAGE 1~5)
    - Update file structure: gui_py/main.py -> hardware_test.py
    - Use absolute ~/ paths for motor_id_check.py / motor_test_1.py so they
    run from any directory
2026-06-18 Fix motor port, add IMU covariance, remove obsolete files
    - Fix all motor port refs /dev/ttyACM0 → /dev/motor (udev symlink)
    - Add orientation/angular_velocity/linear_acceleration covariance to
    ebimu_publisher so robot_localization EKF treats IMU correctly
    - Delete real_robot_driver.py (topic conflict with EKF, wrong RPM factor)
    - Delete real_robot.launch.py (syntax error, references non-existent executables)
    - Delete imu_topic.py (publishes String instead of sensor_msgs/Imu, EKF-incompatible)
    - Add development roadmap and headless odometry verification guide to README
    [ebimu_publisher.py, motor_drive_1.py, motor_node_1.py, real_robot_driver_260519.py]
2026-06-18 Fix imu_test port /dev/ttyUSB0 → /dev/ttyimu
    [imu_test_1.py, imu_test_2.py]
2026-06-18 Fix Tube-MPC bridge so it actually produces motion
    The bridge node never moved the robot: the reference trajectory was
    re-anchored to the current pose each cycle (so tracking error was always
    zero), the feedforward reference input was dropped, and the tube ancillary
    term read static zero buffers. The augmented model is also hard-locked to
    a 4-step horizon while the default/README used 6, which crashed the QP.
    - Align horizon to 4 everywhere (default param, docstring, README STAGE 6)
    - World-frame path reference: anchor qRef[:,0] at the closest path point
    and walk forward by arc length -> real cross-track/heading error
    - Restore feedforward: cmd = uRef + correction
    - Propagate tube nominal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
2026-06-18 Tune Tube-MPC planner so the QP is feasible
    With R=0.01 the LQR ancillary gain K reached ~10, so the rigid-tube
    constraint tightening reserved up to ~2 m/s / ~4 rad/s of input authority
    for K*e -- far beyond the +-0.5 input bound. The tightened input set became
    empty (u_b = 0.5 - 1.98 < 0), making solve_qp infeasible every cycle.
    Soften K (R: 0.01 -> 5.0) and shrink the tube (e_min: +-0.2 -> +-0.05) so
    K*e_bound stays within the input limits. Verified end-to-end against the
    real TubeMPCPlanner: on-path cmd=[0.20, 0.00], off-path the QP solves and
    steers back toward the path.
2026-06-18 Document the Tube-MPC no-motion debugging history
    Record the four compounding root causes (horizon mismatch, zero tracking
    error from re-anchored reference, dropped feedforward, inert tube term +
    empty tightened input set) and their fixes in the README debugging log.
2026-06-21 Explain why odom quality governs SLAM stability in README
    Add a Phase 2 note covering the odom-as-prior role, which instability
    types scan matching can/can't correct, the correction layers in
    my_cartographer.lua, and why Phase 1 odom calibration must come first.
2026-07-07 Identify USB devices by chip/product so they survive swaps
    Match the motor by vendor/product id (unique QinHeng chip) and the
    lidar by its CP2102N product string instead of hard-coded serials, so
    replacing the lidar or motor with the same-chip model no longer requires
    editing the rules. Document the swap procedure and its limits in README.
2026-07-07 Tweak hardware test scripts for bench testing
    Point IMU test scripts at /dev/ttyUSB0, bump motor test RPM to 100, and
    add clarifying comments.
2026-07-07 Point IMU test scripts back at /dev/ttyimu
    The udev rule creates the /dev/ttyimu symlink, so use it instead of the
    raw /dev/ttyUSB0 that breaks when USB enumeration order changes.
2026-07-08 docs: README 코드 대조 검증 수정 + 향후 개발 방향 + Fable 추론 방식 문서 추가
    - README 오류 수정: 라인 참조(/600.0 팩터 80-81행, wheel_base 39행),
    파일 구조에 relayrobot_driver 패키지 추가, STAGE 4 launch 구성 명시(LiDAR 포함)
    - Phase 5 이후 향후 개발 방향 섹션 추가 (localization 모드, Nav2 병행,
    동적 장애물, 멀티센서, 모바일 매니퓰레이션, 운용 안정화)
    - FABLE_REASONING.md: 재사용 가능한 작업 원칙 7가지 + 유형별 절차 + 프롬프트 블록
2026-07-09 docs: 2026-07-09 디버깅 로그 추가 (하드웨어 브링업/EKF NaN/분기 정리)
    레거시 real_robot.launch.py(motor_node_1 공분산 1e-9)로 인한 EKF NaN 오진,
    모터↔IMU 포트 스왑 확정 과정, 원격 분기(ahead3/behind21) 정리 교훈 기록.
    다음에 동일 혼동 방지용 체크리스트 포함.
2026-07-12 docs: 최초 연결 확인 절차 정리 + check_devices.sh 칩 매핑 버그 수정
    - check_devices.sh: 모터/IMU 칩 매핑이 거꾸로(모터=CP210x, IMU=1a86)여서
    링크 미생성 시 모터 포트를 IMU로 오판하던 버그 수정. 정본 규칙과 일치시킴
    (모터=1a86:55d3 ttyACM, 라이다=CP2102N, IMU=CP2102). 모터 ttyACM 검색 추가.
    - README: "Step 0: 연결 확인(check_devices.sh)" 신설, Step 1-B raw-read 검증
    + dialout/MODE=0666 권한 안내, 포트 스왑 사고 경고 추가(2026-07-09 반영).
    - ddsm_raw_monitor.py 추가(README에서 참조하는 모터 raw 응답 진단 도구).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
    [ddsm_raw_monitor.py]
2026-08-22 fix: ROS 2 Foxy 호환성 확보 + 패키지 의존성 정리
    - package.xml의 buildtool_depend를 ament_cmake -> ament_python으로 수정
    (export의 build_type과 불일치해 rosdep 해석이 어긋나던 문제)
    - 런타임에 실제로 쓰는 exec_depend 명시: tf_transformations, tf2_ros,
    python3-serial, python3-numpy, python3-scipy, python3-tk
    - cartographer.launch.py: occupancy grid 노드 실행파일 이름이 배포판마다
    다르므로(Foxy=occupancy_grid_node, Humble/Jazzy=cartographer_occupancy_grid_node)
    설치된 쪽을 찾아 쓰도록 변경
    - bridge_node.py: pathlib.Path를 FsPath로 별칭 처리해 이름 충돌 방지
    - README: Foxy(20.04) 지원 추가 및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
2026-08-22 feat: 실측 바퀴 제원 반영 + 오도메트리 캘리브레이션 노드 추가
    실측값: 바퀴 지름 65mm(r=0.0325), 양 바퀴 중심간 거리 220mm
    기존에는 명령 경로와 오도메트리 경로가 서로 다른 기구학 상수를 써서
    같은 바퀴인데 반경이 43% 어긋나 있었다.
    - motor_drive_1.py (cmd_vel->RPM) : r=0.035, base=0.2
    - real_robot_driver_260519.py (RPM->odom) : r=0.05, base=0.165
    이 상태로는 캘리브레이션을 해도 두 상수의 비율만 측정하게 된다.
    변경 내용
    - real_robot_driver_260519.py: wheel_radius/wheel_base/rpm_scale/port를
    ROS 파라미터로 선언하고 MotorDriver에 그대로 주입 -> 기구학 상수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
2026-08-22 fix: DDSM400 통신 규약 바로잡기 + IMU 3필드 출력 대응 + EKF 융합 전략 변경
    2026-08-22 실기 테스트로 확인한 내용을 반영.
    [모터] motor_drive_1.py
    - 초기화를 {"T":11002,"id":N} -> {"T":11002,"type":210} 으로 수정.
    펌웨어(ddsm_example.ino: set_ddsm_type)는 115/210 만 인정하고 DDSM400 은
    DDSM210 계열 프로토콜을 쓴다. 전원 사이클당 1회 필요하며, 이걸 빼먹으면
    보드가 구동 명령(T:10010)에 응답조차 하지 않는다.
    -> "연결은 되는데 모터가 안 도는" 증상의 실제 원인이었다.
    - cmd 단위는 RPM 이 아니라 0.1RPM. 실측 cmd 100 -> spd 105 회신.
    calculate_rpms() 의 x60 을 x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
    [ebimu_publisher.py, motor_drive_1.py, motor_test0822.py, real_robot_driver_260519.py]
2026-08-22 docs: 2026-08-22 디버깅 로그 정리 (DDSM400 통신 규약 / IMU / 오도메트리)
    기존 docs/ 구조(DEBUG_LOG_YYYY-MM-DD.md + docs/wiki/)를 그대로 따랐다.
    신규
    - docs/DEBUG_LOG_2026-08-22.md
    겪은 문제와 원인, 왜 헷갈렸는지, 확정된 하드웨어 사실 표, 측정 결과,
    미해결 항목, 다음에 할 체크리스트를 7월 로그와 같은 구성으로 정리.
    갱신
    - docs/wiki/logs/Debugging_Experience.md: 7~12번 항목 추가
    - docs/wiki/entities/Relay_Robot_Hardware.md: DDSM400 통신/부호 규약,
    IMU 출력 포맷, 기구학 설정값 표 추가. 제어 PC 환경을 실제(Foxy/20.04)로 정정.
    - docs/wiki/log.md: 2026-08-22 타임라인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
2026-09-03 docs: 2026-09-03 기구학 상수 확정 + 젯슨 부팅 문제 + 원격 접속 방침
    실기에서 확정된 값이 저장소로 돌아오지 않아, 이미 닫힌 항목을 다시
    "미해결"로 다루는 일이 반복됐다. 현재 상태를 정본으로 못박는다.
    확정 (재측정 불필요):
    - wheel_radius = 0.0325 (지름 65mm)
    - wheel_base = 0.22
    - rpm_scale = 600 (명령 ×600 / 계측 /600.0 일치)
    - 8/22 의 "지름 6.5 vs 역산 7.4cm 14% 불일치" 는 무효.
    근거였던 60cm 가 줄자 실측이 아니라 눈대중이었다.
    추가:
    - docs/DEBUG_LOG_2026-09-03.md — 현재 상태의 정본
    - 남은 미해결 3건(유령 거리 / 타임스탬프 / IMU frame_id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
2026-09-03 docs: rpm_scale 주석을 현재 단위 규약에 맞게 정정
    8/22 수정(calculate_rpms ×60 → ×600) 이후에도 "명령 쪽과 10배 어긋남"
    주석이 남아 있어, 파일을 여는 사람마다 이미 맞는 값을 의심하게 됐다.
    지우지 않고 실제 단위 유도를 적어 넣는다.
    - real_robot_driver_260519.py: spd = 0.1RPM (10 RPM = spd 100) 에서
    rpm_scale = 10 × 60 = 600 이 나오는 과정과 왕복 검증 예시를 명시.
    명령 쪽 ×600 과 서로의 역연산임을 못박고, odom 거리가 안 맞을 때
    이 팩터가 아니라 유령 거리를 먼저 의심하라고 안내.
    - motor_drive_1.py: calculate_rpms() 의 ×600 이 rpm_scale(÷600) 의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
    [motor_drive_1.py, real_robot_driver_260519.py]
2026-09-03 docs: 젯슨 셋업 가이드 추가 + 목표 환경을 JetPack 6.2.1 / Humble 로 확정
    목표 배포판 정정 (중요):
    JetPack 6.x 는 Ubuntu 24.04 가 아니라 22.04(L4T 36.x) 다. 따라서 Jazzy 가
    아니라 Humble 이고, README 호환표에서 Humble 은 Gazebo 시뮬까지 지원한다.
    어제 DEBUG_LOG_2026-09-03.md 4절에 "JetPack 6 -> Jazzy -> Gazebo 불가" 로
    적은 것은 오류이므로 바로잡는다.
    JetPack 5.1.x -> L4T 35.x -> Ubuntu 20.04 -> Foxy (2023-05 EOL)
    JetPack 6.2.1 -> L4T 36.4 -> Ubuntu 22.04 -> Humble (LTS 2027-05) <- 목표
    Humble 이 전 항목에서 우위이므로 Foxy 를 고를 이유가 없다. JetPack 5.1.3 은
    목적지가 아니라 QSP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
2026-09-06 feat: 원격 운용 셋업 — Humble 설치/원격 준비 스크립트 + use_lidar 옵션
    젯슨(JetPack 6.2.x / Ubuntu 22.04 / arm64)에서 ROS 2 Humble 로 원격 운용을
    시작하기 위한 셋업 일체. 목표는 "PC 에서 SSH 로 붙어 STAGE 4 오도메트리를
    검증할 수 있는 상태"다.
    scripts/setup_humble.sh (신규)
    - ROS 2 apt 저장소 등록 + ros-humble-desktop + 프로젝트 필수 패키지
    - xacro 를 명시적으로 설치: real_robot_260519.launch.py 가 `import xacro` 로
    URDF 를 파싱하는데 desktop 메타패키지에 포함돼 있지 않다
    - colcon / rosdep / tmux, Python 의존성(cvxpy·polytope·osqp·cvxopt 등), dialout
    - jammy/arm64 가 아니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
2026-09-06 fix(build): rosdep 을 막던 ament_python 의존 제거 + mpc 패키지 setup.cfg 추가
    젯슨에서 워크스페이스를 처음 빌드하면서 드러난 패키징 버그 2건.
    1) package.xml 5개의 <buildtool_depend>ament_python</buildtool_depend> 삭제
    ament_python 이라는 rosdep 키는 존재하지 않는다. 파이썬 패키지의 빌드 타입은
    <export><build_type> 에서 선언하는 것이고 의존성으로 적는 게 아니다.
    두 줄이 모두 있었고, 이 때문에 rosdep 이 멈췄다:
    ERROR[ebimu_pkg]: Cannot locate rosdep definition for [ament_python]
    colcon 은 rosdep 을 쓰지 않아 빌드는 그냥 됐기 때문에 여태 안 드러났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
2026-09-06 docs: 2026-09-06 원격 개발 환경 구축 로그
    젯슨 원격 개발 환경이 오늘 처음으로 동작 가능한 상태가 됐다. 그 경위와
    다음 세션이 알아야 할 것을 DEBUG_LOG_2026-09-06.md 에 정리했다.
    핵심:
    - ssh robot 비밀번호 없이 접속 (키 등록 완료)
    - 젯슨 워크스페이스 최초 빌드 성공 (6/6), 노드 9개 인식
    - numpy 2.2.6 은 tube MPC 스택이 요구하는 것이므로 1.x 로 내리지 말 것.
    transforms3d 를 0.4.2 로 올려서 tf_transformations 충돌을 해결했다.
    - USB 는 아직 안 꽂았고 실기 검증은 전무하다. 다음 세션의 시작점.
    기록해둔 함정 3가지:
    - ~/.bashrc 의 비대화형 가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
2026-09-06 chore: 추적되던 __pycache__ / egg-info 를 인덱스에서 제거
    .gitignore 에 __pycache__/ 규칙이 이미 있었지만, 그 규칙이 추가되기 전에
    커밋된 파일 14개가 계속 추적되고 있었다. 노드를 실행할 때마다 .pyc 가
    바뀌므로 젯슨에서 git pull 이 매번 "local changes would be overwritten"
    으로 막힌다. 오늘 실제로 걸렸다.
    git rm -r --cached 로 인덱스에서만 제거했다. 실제 파일은 그대로 있고
    앞으로는 .gitignore 가 잡는다. egg-info 규칙도 함께 추가.
    Claude-Session: https://claude.ai/code/session_014iJHkPiCZ4qCBtf1tar78e
2026-09-06 feat(ops): 안전 종료 스크립트를 파일로 분리 + 노드 목록 낡음 수정 + PC 쪽 자동 대기
    robot-off 를 실제로 쓰기 전에 점검하다 나온 문제 3가지를 정리했다.
    1) scripts/robot-off.sh 신규 — 저장소에 파일로 존재하게
    여태 setup_remote_ops.sh 안의 heredoc 으로만 있어서, 내용을 보려면
    설치 스크립트를 열어야 했고 diff 도 안 잡혔다. 독립 파일로 빼고
    setup_remote_ops.sh 는 이 파일을 복사해 가도록 바꿨다.
    설치 시 항상 tr 로 LF 정규화한다. 저장소가 윈도우 PC 를 거치면 CRLF 로
    체크아웃돼서 셰뱅이 깨지고, 그러면 정작 끌 때 실행이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
2026-09-06 fix(ops): robot-off 의 종료 패턴을 실제 노드 프로세스로 좁힘
    install/ 만으로 pkill -f 를 걸면 명령줄에 그 경로 문자열이 들어 있기만 해도
    잡힌다. 실제로 검증 중에 워크스페이스 경로를 언급한 ssh 셸이 함께 걸렸다.
    종료 직전이라 큰 피해는 없지만, tmux 세션이나 로그 수집 셸을 예고 없이
    죽일 수 있다.
    노드 실행파일은 반드시 install/<패키지>/lib/<패키지>/<이름> 에 있으므로
    패턴에 /lib/ 를 요구하도록 바꿨다. 실제 노드만 걸린다.
    Claude-Session: https://claude.ai/code/session_014iJHkPiCZ4qCBt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
2026-09-06 docs: 안전 종료 스크립트 정리 내역을 2026-09-06 로그에 추가
    robot-off 를 파일로 분리한 이유, 노드 목록이 낡아서 main_driver 를 못 죽이던
    문제, pkill -f 패턴을 /lib/ 까지 좁힌 이유, PC 쪽 robot-off.ps1 사용법과
    dry-run 검증 결과를 6절에 정리했다.
    실제 전원 차단은 아직 안 해봤다는 점도 함께 적어뒀다.
    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
2026-09-06 fix(ops): robot-off.ps1 을 UTF-8 BOM 으로 저장 — 파싱 실패 수정
    BOM 없이 저장했더니 실행이 안 됐다.
    Missing expression after ','. (19행)
    Windows PowerShell 5.1 은 BOM 이 없는 .ps1 을 UTF-8 이 아니라 ANSI(CP949)로
    읽는다. 한글 주석의 UTF-8 바이트가 엉뚱한 문자로 해석되면서 파서가 죽었다.
    PowerShell 7 은 UTF-8 을 기본으로 보기 때문에 안 겪는 문제다.
    BOM 을 넣어 해결했고, 헤더에 그 이유를 적어뒀다 (편집기가 BOM 을 떼면 재발한다).
    헤더에 실행 정책 우회 방법도 함께 적었다. 윈도우 기본값이 Restricted 라
    그냥 실행하면 UnauthorizedAccess 로 막힌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
2026-09-06 docs: 센서 실기 검증 결과 반영 — 라이다 모델 정정 + 전원 사양 + 드라이버 중복 경고
    USB 를 꽂고 원격으로 노드를 띄워 확인한 결과를 문서에 반영했다. 모터는 아직 안 돌렸다.
    검증된 것:
    - ebimu_publisher 50.0 Hz, 쿼터니언 정상
    - sllidar_node 10.0 Hz, health OK, 스캔당 유효 포인트 2780개 (0.10~5.06 m)
    - 두 노드 동시 구동 시 젯슨 소비전력 4.04 W
    - udev 가 의도대로 동작 — CP210x 두 개가 VID:PID 가 같은데도 각자 잡혔다
    정정 1) 라이다는 A1 이 아니다
    sllidar_a1_launch.py 로는 SL_RESULT_OPERATION_TIMEOUT 으로 죽는다. 포트는
    맞았고 보드레이트가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
2026-09-06 feat(ops): robot-up.sh — tmux 로 노드를 상시 기동
    ssh 로 그냥 띄우면 연결이 끊기는 순간 노드가 통째로 죽는다. 무선은 반드시
    끊긴다. tmux 안에서 돌려서 SSH 가 끊겨도 노드가 살아있게 한다.
    nohup 도 살긴 하지만 로그를 다시 볼 수 없어서 tmux 를 쓴다.
    robot-up.sh 센서만 (라이다 + IMU) — 모터를 안 건드리니 로봇이 안 움직인다
    robot-up.sh full real_robot_260519.launch.py 전체 (모터 + EKF)
    robot-up.sh status 노드 목록과 토픽 발행 주기
    robot-up.sh stop 전부 종료
    오늘 실기에서 확인한 두 함정을 스크립트에 박아뒀다:
    - 라이다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
2026-09-06 refactor: 레거시 모터 드라이버 제거 (relayrobot_driver/main_driver)
    2026-07-09 로그에 "레거시 motor_node_1.py 정리/삭제해 혼동 원천 차단" 이
    TODO 로 남아 있었다. 두 달간 방치되는 동안 실제로 한 번 시간을 날렸다
    (엉뚱한 파일의 공분산을 고치고 있었다). 오늘 ros2 run 대상들을 맞춰보다
    다시 걸려서 정리한다.
    제거한 것:
    src/relayrobot_driver/relayrobot_driver/motor_node_1.py
    src/relayrobot_driver/relayrobot_driver/motor_drive_1.py
    setup.py 의 main_driver entry_point
    왜 지웠나 — 2026-06-18 이후 방치돼 확정 사항이 하나도 반영돼 있지 않다:
    기구학 상수 (9/3 확정)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
2026-09-06 fix: 누락된 setup.py 변경 반영 — main_driver entry_point 제거
    직전 커밋(fcda232)에서 파일 삭제만 스테이징되고 setup.py 수정이 빠졌다.
    그래서 entry_point 는 그대로 남아 이미 지운 motor_node_1 을 가리키고 있었다.
    젯슨에서 클린 재빌드해도 main_driver 실행파일이 계속 생성됐다.
    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
2026-09-06 docs: 데이터 구독 방법 3가지 정리 + 오늘 진행분 반영
    7.5절 신설 — "젯슨에서 도는 센서 데이터를 어디서 어떻게 받아보나".
    세 갈래를 쓰임에 따라 나눠 적었다.
    A. ssh + ros2 topic 준비물 없음. 지금 바로 됨. 값 확인/디버깅용
    B. 구독 노드 작성 값을 가공·판단에 쓸 때. LaserScan 구독 최소 예제 포함
    C. 같은 대역 DDS PC 에 ROS 2 설치. rviz 시각화는 이것뿐
    B 에는 실측에서 걸린 함정을 같이 적었다. /scan 의 ranges 에는 inf/nan 이
    섞여 있어서 거르지 않고 min()이나 평균을 내면 결과가 통째로 망가진다.
    실제로 전체 배열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
2026-09-06 chore: robot-up.sh / robot-off.sh 에 실행 비트 부여
    윈도우에서 만든 파일이라 100644 로 커밋됐다. 젯슨에서 chmod +x 를 하면
    그게 로컬 변경으로 잡혀 git pull 이 막힌다. 실제로 오늘 막혔다.
    setup_humble.sh / setup_remote_ops.sh 는 이미 100755 였다. 새로 추가한
    두 개만 맞춰준다. 이제 클론만 하면 바로 실행 가능하다.
    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
2026-09-06 docs: 2026-09-06 결론 — 원격 센서 데이터 수신 성공
    문서 맨 앞에 오늘의 성과를 한 눈에 보이도록 정리했다.
    아침에는 비밀번호로 ssh 접속만 되던 상태였고, 저녁에는 PC 에서 명령 한 줄로
    젯슨의 노드를 띄우고 실제 센서 값을 읽어오는 데까지 갔다.
    /scan 10.0 Hz 유효 2795개, 0.11~5.06 m
    /ebimu_data 50.0 Hz
    노드는 tmux 안에서 돌아 SSH 를 끊어도 죽지 않는다(연결을 끊었다 다시 붙어
    PID 가 동일한 것을 확인).
    모터는 아직 한 번도 안 돌렸다는 점을 함께 명시했다. 다음 세션의 시작점이다.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
2026-09-07 feat: 오도메트리 원격 진단 노드(odom_check) + PC DDS 시험 워크플로우 정리
    - tools/odom_check.py: PC(Jazzy)에서 젯슨(Humble) 토픽을 DDS로 구독해
    명령/바퀴(/odom_raw)/IMU/EKF(/odom) 4개 소스를 실시간 비교.
    ① 선속도 스케일(rpm_scale/wheel_radius) ② 회전 스케일(wheel_base) 검증.
    IMU 절대 yaw 기준이라 회전 오차는 줄자 없이 잡힌다. reset 서비스 +
    rqt_plot용 6개 Float64 토픽 발행. PC 오프라인 기동 검증 완료.
    - docs/DEBUG_LOG_2026-09-07.md: PC는 Jazzy로 cross-distro 통함(Humble 불필요),
    ROS_DOMAIN_ID=0(문서의 30은 옛값), conda가 rclpy 가리는 함정,
    시험 워크플로우(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
2026-09-13 feat: SLAM→A*→Tube-MPC 체인 정비 — 프레임 정합/watchdog/장애물 팽창 + 원격 관측
    조사 결과 자율주행 코드는 이미 끝까지 있었다. SLAM 실행에 새로 만들 파일은 0개다.
    막혀 있던 것은 SLAM 을 켜는 순간 깨지는 구멍 3개와, 원격에서 상태를 볼 수단의 부재였다.
    코드
    - tf2 로 map 프레임 일원화: bridge_node/path_planner 가 /odom(odom 프레임) 위치와
    map 프레임 경로·목표를 변환 없이 빼고 있었다. SLAM 드리프트 보정분이 그대로
    추종 오차로 둔갑하는 구조. global_frame(기본 map) → base_link TF 로 교체.
    global_frame:=odom 이면 SLAM 없이도 동작.
    - /cmd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
2026-09-13 docs(wiki): concepts 갱신 + 고아 링크 2개 채움 — TF/MPC 설계 근거 기록
    SCHEMA 의 Ingest 워크플로우는 "관련 Entity·Concept 페이지 갱신 → index/log 갱신" 인데
    직전 커밋에서 index/log 만 고치고 concepts 를 빠뜨렸다. 그 결과 System_Architecture 의
    데이터 흐름이 낡은 채로 남아 있었다(4단계가 "GUI/MPC가 map 상의 위치를 바탕으로" 인데
    실제 코드는 odom 프레임을 쓰고 있었다 — 오늘 고친 바로 그 결함).
    - 신규 concepts/TF_Coordinate_System.md — index 에 링크만 있고 페이지가 없던 고아 링크.
    프레임 혼용 시 추종오차에 map→odom 이 섞이는 구조, TF 조회에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
2026-09-22 feat: IMU 를 선택 사항으로 — use_imu 스위치 + /odom_raw 구독자 전수 정리
    2D SLAM 에서 yaw 를 잡는 주체는 IMU 가 아니라 라이다 scan matching 이다. 바퀴
    오도메트리는 스캔 사이를 메우는 초기 추정값일 뿐이고, 누적 드리프트는
    cartographer 가 map->odom TF 로 흡수한다. my_cartographer.lua 는 원래부터
    use_imu_data=false 였으므로 막고 있던 것은 TF 배선 하나뿐이었다.
    ekf.yaml 은 yaw 소스가 IMU 단독이라, IMU 노드만 빼면 EKF 는 방향 소스를 잃고
    드라이버는 TF 를 안 내므로 odom->base_link 가 통째로 끊겼다. cartographer 는
    그 상태에서 에러 없이 조용히 아무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
2026-09-22 chore: 안 쓰는 파일 30개를 old_file/ 로 이동 + 활성 파일 지도 작성
    모터 관련 코드 사본이 여러 벌이라 "지금 실제로 도는 게 어느 것인지" 가 헷갈렸다.
    지우지 않고 old_file/<원래 경로> 로 옮겼다. 원래 경로를 유지하므로 old_file/ 만
    떼면 복구된다. COLCON_IGNORE 를 넣어 빌드에서 제외했다.
    옮긴 것:
    - src/ddsm_example/ddsm_python/ 전체 11개 — 벤더 예제 + 옛 드라이버 사본.
    실제로 도는 것은 relayrobot_description/motor_drive_1.py 하나다.
    그 중 motor_node_1.py 는 odom + TF 를 직접 쏘므로 지금 띄우면 TF 이중 발행
    - mpc_tubempc/main_loop.py, ReferenceGenerator.py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
2026-09-22 refactor: 중복 노드 통합(relayrobot_driver 폐지) + 문서 낡은 내용 정리
    odom_sub(relayrobot_driver)와 odom_listener(relayrobot_description)가 완전히 같은
    일을 했다 — 둘 다 /odom 을 구독해 x, y, yaw 를 출력. 패키지 하나가 그 중복 노드
    하나 때문에 존재하고 있었다. odom_listener 로 합치고 패키지는 old_file/ 로.
    합치면서 odom_sub 쪽 장점을 가져왔다:
    - 출력을 print 가 아니라 get_logger() 로. print 는 ROS 로그에 안 남고 launch 로
    여러 노드를 띄우면 출력이 섞여 순서가 뒤엉킨다
    - destroy_node() 를 finally 안으로. 예외로 빠져나갈 때도 정리된다
    워크스페이스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
2026-09-22 docs: README 두 벌을 하나로 통합 + 남아 있던 EKF 전제 서술 정리
    README.md(1350줄)와 README_ROBOT.md(509줄)가 크게 겹치는데 서로 다른 시점에
    갱신돼서 모순이 쌓였다. 바로 앞 커밋에서 발견한 "Jazzy/Ubuntu 24.04" 오류가
    정확히 그 증상이다 — README.md 는 배포판 호환표로 Humble 을 다루고 있었는데
    README_ROBOT.md 만 Jazzy 로 굳어 있었다. 문서가 둘이면 한쪽만 고치게 된다.
    README.md 를 정본으로 삼았다. 상위집합이다 — STAGE 0~6, 젯슨/PC 터미널 분리,
    robot-up.sh, mpc_sim.py 리허설, 비상정지, QP_FAILED 규명이 전부 이쪽에만 있었다.
    README_ROBOT.md 의 고유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
2026-09-22 docs: CLAUDE.md 신설 — 세션 시작 시 docs 부터 읽게 + 오늘 작업 docs 반영 완료
    세션이 바뀔 때마다 "지금 뭐가 막혀 있는지" 를 다시 설명해야 했다. CLAUDE.md 는
    세션 시작 시 자동으로 읽히므로, 거기에 진입점과 현재 막힌 지점을 박아둔다.
    CLAUDE.md 내용:
    - 0절: docs/DEBUG_LOG_<최신>.md 를 먼저 읽는다. 날짜가 최신인 것이 정본이고
    각 문서 0절에 확정/미결이 정리돼 있다. 코드와 git 히스토리만으로는 "왜 이렇게
    했는지" 와 "무엇이 의도적으로 미해결인지" 를 알 수 없다
    - 0절: git fetch 로 원격과 비교한다. git status 가 clean 한 것은 로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
